ftkalcevic/DABClockRadio/DABClockRadio/main.cpp

/*
 * DABClockRadio.cpp
 *
 * Created: 24/09/2016 10:32:10 AM
 * Author : Frank Tkalcevic
 */ 

#include <avr/io.h>
#include <avr/interrupt.h>
#include <avr/pgmspace.h>
#include <avr/eeprom.h>
#include <util/delay.h>
#include <string.h>
#include <stdlib.h>
#include <time.h>

#include "..\images\font.h"

#include "ic2_7seg.h"
#include "serial.h"
#include "pictiva.h"
#include "monkeyboarddab.h"

//#include "..\..\images\consolas.h"


#define BTN_SNOOZE		0x0001
#define BTN_SLEEP		0x0002
#define BTN_RADIO_OFF	0x0004
#define BTN_RADIO_ON	0x0008
#define BTN_TIME_SET	0x0010
#define BTN_FWD_FAST	0x0020
#define BTN_FWD_SLOW	0x0040
#define BTN_ALARM1		0x0080
#define BTN_REV_FAST	0x0100
#define BTN_REV_SLOW	0x0200
#define BTN_ALARM2		0x0400
#define MAX_BUTTONS		11

#define SLAVE_ADDR (0x70<<1)

static CSerial< CSerialImpl<CMegaSerialC0,64,64>
#ifndef DEBUG
, false
#endif
> terminal;
IMPLEMENT_SERIAL_INTERRUPTS( C0, terminal )

static SevenSeg< CSerialTxn< CSerialTxnImpl< CMegaI2CE, 64, 8> >, SLAVE_ADDR> sevenSeg_I2C;
IMPLEMENT_SERIAL_TXN_INTERRUPTS(E,sevenSeg_I2C)
static CMonkeyBoardDAB<CSerial< CSerialImpl<CMegaSerialE0,64,64> >,
CSerial< CSerialImpl<CMegaSerialC0,64,64>
#ifndef DEBUG
, false
#endif
>
 > dab(&terminal);
IMPLEMENT_SERIAL_INTERRUPTS( E0, dab )
static Pictiva display;

//SevenSeg< CSerialTxn< CSerialTxnPolledImpl< CMegaI2CE > >, SLAVE_ADDR> sevenSeg_I2C;

//#define SET_CLOCK_AT_POWERUP
#define SET_CLOCK_TIMEOUT	300	// Try to set the clock for 5 minutes
static time_t clock_secs = 0;
static bool bClockInitialised=false;
static bool bDABClockEnabled = false;
static uint32_t radioTimer;

static void ScrollText(bool bRedraw=false);
static void PrimeAlarms();
static void AlarmOff();
static void RadioOff(bool bForce = false);
static void DrawMenu();
static void WriteEEPROM();
static bool DrawProgramText(bool bNewText);
static void SetPixel( uint16_t *pixel, uint8_t c, uint8_t nPos );
static void DrawSignalStength( uint8_t strength );

enum class AlarmType: uint8_t
{	
	Off=0,
	OneOff,
	Scheduled,
	Max
};

struct Alarm
{
	AlarmType type;
	// program ? -1: beeper
	uint8_t nHour;	/**< 1-12 */
	uint8_t nMin;	/**< 0-59 */
	uint8_t nAmPm;	/**< 0-1 */
	uint8_t nDay;	/**< 1-31 */
	uint8_t nMonth;	/**< 0-11 */
	uint16_t nYear;	/**< YYYY */
	uint8_t dow;			// Days of week bitmask: bit 0 is sunday.
};

#define MAX_ALARMS	4
//static Alarm alarms[MAX_ALARMS];
static time_t nNextAlarmDue;
static time_t nAlarmOffTime = 0;
static bool bAlarmOn = false;
//static uint8_t nAlarmRunTime;	// in minutes
//static uint8_t nSleepTime;		// in minutes
//static uint8_t nSnoozeTime;		// in minutes
//static uint8_t nTimeIntensity;
//static uint8_t nDABIntensity;


static struct  SEEPROMBlock
{
	uint16_t nLastPlayedProgramIndex;
	Alarm Alarms[MAX_ALARMS];
	uint8_t nAlarmRunTime;	// in minutes
	uint8_t nSleepTime;		// in minutes
	uint8_t nSnoozeTime;	// in minutes
	uint8_t nTimeIntensity;
	uint8_t nDABIntensity;
	uint16_t crc16;			// CRC of eeProgram[20] to verify if EEPROM has been set.
} settings;

SEEPROMBlock eeprom_data EEMEM;

// Display mode - what is the display showing.
enum class DisplayMode: uint8_t
{
	Off,
	Playing,
	Tuner,
	Menu,
	Scanning
} displayMode = DisplayMode::Off;


// Program Info
struct Programs
{
	const char *sShortName;
	const char *sLongName;
};
static Programs *programs;
static uint16_t nPrograms;
static uint16_t nProgramIdx;
static char *sProgramNames;
//static uint16_t nLastPlayedProgramIndex;
//static char sLastPlayedProgram[sizeof(eeProgram)];
static uint8_t lastSignalStrength =0;

static uint16_t nNextProgram;
static uint8_t nLastVolume = 0;	// What the volume is.
static uint8_t volumeSetting = 0;	// What to set it to.


// Programme text and scrolling.
#define PROGRAM_TEXT_POS	36
static char sCurrentProgramText[256];
static uint16_t textXShift = 0, textXShiftMax;
static int16_t xoffs;




static enum class ClockRadioState: uint8_t
{
	Off,
	Idle,
	Menu
} clockRadioState = ClockRadioState::Off;


static uint16_t nTunerPosition, nTunerTarget;
const int16_t TUNER_WIDTH = 120;	// Multiple of 3
const int16_t TUNER_WIDTH_WORDS = TUNER_WIDTH/3;	// Multiple of 3
const int16_t SELECTOR_WIDTH = TUNER_WIDTH/2;
const int16_t ROW_HEIGHT = 12;
static uint16_t *paintBuffer;

static void InitI2C()
{
	PR.PRPE &= ~PR_TWI_bm;
	sevenSeg_I2C.Init();
}

static void ClearDisplay()
{
	sevenSeg_I2C.ClearDisplay();
}

static void FlashColon(bool bOn)
{
	// at the 1/2 second mark, turn off the colon (row 4)
	uint8_t data[] = {SLAVE_ADDR, 4, (uint8_t)(bOn?0xFF:0), 0 };
	sevenSeg_I2C.SendTxn(data, countof(data));
}


static void ShowTime( long nSeconds )
{
	struct tm t;

	gmtime_r((time_t*)&nSeconds, &t);

	//terminal.Send( "Tick ");
	//terminal.Send(t.tm_mday);
	//terminal.Send('/');
	//terminal.Send(t.tm_mon);
	//terminal.Send('/');
	//terminal.Send(t.tm_year+1900);
	//terminal.Send(' ');
	//
	//if (t.tm_hour < 10 )
	//terminal.Send(' ');
	//terminal.Send(t.tm_hour);
	//terminal.Send( ":");
	//if ( t.tm_min < 10 )
	//terminal.Send('0');
	//terminal.Send(t.tm_min);
	//terminal.Send( ":");
	//if ( t.tm_sec < 10 )
	//terminal.Send('0');
	//terminal.Send(t.tm_sec);
	//terminal.SendCRLF();

	static const uint8_t numbertable[] = {
		0x3F, /* 0 */
		0x06, /* 1 */
		0x5B, /* 2 */
		0x4F, /* 3 */
		0x66, /* 4 */
		0x6D, /* 5 */
		0x7D, /* 6 */
		0x07, /* 7 */
		0x7F, /* 8 */
		0x6F /* 9 */
	};

	bool pm = false;
	struct 
	{
		uint8_t addr;
		uint8_t row;
		uint16_t data[5];
	} data;
	data.addr = SLAVE_ADDR;
	data.row = 0;
	if ( t.tm_hour > 12 )
	{
		t.tm_hour -= 12;
		pm = true;
	}
	if ( t.tm_hour == 0 )
		t.tm_hour = 12;
	if ( t.tm_hour < 10 )
		data.data[0] = 0;
	else
	{
		data.data[0] = numbertable[1];
		t.tm_hour -= 10;
	}
	data.data[1] = numbertable[t.tm_hour];
	//data[2] = (nSeconds & 1) ? 0xFF : 0;
	data.data[2] = 0xFF;

	data.data[3] = numbertable[t.tm_min/10];
	data.data[4] = numbertable[t.tm_min%10];

	if ( pm )
		data.data[4] |= 0x80;
	
	sevenSeg_I2C.SendTxn( (uint8_t *)&data, sizeof(data) );
}

static void ShowProgram()
{
	const char *sProgram = programs[settings.nLastPlayedProgramIndex].sLongName;

	terminal.Send("ProgramName: ");
	terminal.Send(sProgram);
	terminal.SendCRLF();

	if (  displayMode == DisplayMode::Playing )
	{
		display.ClearWindow( 0, 0, OP_SCREENW - 16*(font_6x13.cols+1), 2*ROW_HEIGHT, true ); 
		display.WriteText( &font_MSShell, 0, 0, sProgram );
	}
}

const char *WeekDay[] = {"Sun","Mon","Tue","Wed","Thu","Fri","Sat"};
const char *Month[] = {"Jan","Feb","Mar","Apr","May","Jun","Jul","Aug","Sep","Oct","Nov","Dec"};

static void ShowDate()
{
	if ( displayMode == DisplayMode::Playing )
	{
		struct tm t;

		gmtime_r((time_t*)&clock_secs, &t);

	
		char s[16];	//Thu 20 Dec 2016
		memset( s, ' ', sizeof(s) );
		uint8_t n = 0;

		if ( t.tm_mday < 10 )
			n++;

		s[n++] = WeekDay[t.tm_wday][0];
		s[n++] = WeekDay[t.tm_wday][1];
		s[n++] = WeekDay[t.tm_wday][2];
		n++;

		if ( t.tm_mday >= 10 )
			s[n++] = '0' + (t.tm_mday / 10 );
		s[n++] =  '0' + (t.tm_mday % 10 );
		n++;

		s[n++] = Month[t.tm_mon][0];
		s[n++] = Month[t.tm_mon][1];
		s[n++] = Month[t.tm_mon][2];
		n++;

		uint16_t y = t.tm_year + 1900;
		s[n++] = '0' + y/1000;
		s[n++] = '0' + (y%1000)/100;
		s[n++] = '0' + (y%100)/10;
		s[n++] = '0' + (y%10);
		s[n] = '\0';

		display.WriteText( &font_6x13, OP_SCREENW - 1 - (font_6x13.cols + 1)*n, 0, s );
	}
}

static void UpdateTime( struct tm &t )
{
	uint32_t seconds = mktime(&t);

	if ( abs((int32_t)seconds -  (int32_t)clock_secs) > 5 )
	{
		bClockInitialised = true;
		terminal.Send( "Setting time: " );
		terminal.Send( (long)seconds );
		terminal.SendCRLF();
		clock_secs = seconds;
		PrimeAlarms();
		ShowTime(clock_secs);
	}
}


static volatile uint32_t ms;

ISR(TCC0_OVF_vect)
{
	ms++;
}

static void ioinit()
{
	// Turn of all peripherals
	PR.PRGEN = 0xFF;
	PR.PRPA = 0xFF;
	//PR.PRPB = 0xFF;
	PR.PRPC = 0xFF;
	PR.PRPD = 0xFF;
	PR.PRPE = 0xFF;
	PR.PRPF = 0xFF;

	// main clock to 32MHz

	// Enable 16MHz Ext Crystal
	OSC.XOSCCTRL = OSC_XOSCSEL_XTAL_256CLK_gc | OSC_FRQRANGE_12TO16_gc;
	OSC.CTRL |= OSC_XOSCEN_bm;
	// Wait till stable.
	while ( (OSC.STATUS & OSC_XOSCRDY_bm) == 0 )
		continue;

	// PLL x2
	OSC.PLLCTRL = OSC_PLLSRC_XOSC_gc | 2;
	OSC.CTRL |= OSC_PLLEN_bm;
	while ( (OSC.STATUS & OSC_PLLRDY_bm) == 0 )
		continue;

	// Select it as the new clock
	_PROTECTED_WRITE(CLK_PSCTRL, 0);
	_PROTECTED_WRITE(CLK_CTRL, CLK_SCLKSEL_PLL_gc);


	// RTC 
	PR.PRGEN &= ~PR_RTC_bm;
	CLK.RTCCTRL =  CLK_RTCSRC_TOSC_gc | CLK_RTCEN_bm;
	RTC.CTRL = RTC_PRESCALER_DIV256_gc;						// 1024Hz / 256 -> 4Hz (so we can flash the : each 1/2 second)

	//// Enable dfll32m
	//OSC.XOSCCTRL = OSC_XOSCSEL_32KHz_gc;
	//OSC.CTRL |= OSC_XOSCEN_bm;
	////while ( (OSC.STATUS & OSC_XOSCRDY_bm) == 0 )
		////continue;
	//OSC.DFLLCTRL = OSC_RC32MCREF_XOSC32K_gc;
	//DFLLRC32M.CTRL = DFLL_ENABLE_bm;

	InitI2C();

	// TCC0 ms counter.
	PR.PRPC &= ~PR_TC0_bm;
	TCC0.CTRLA = TC_CLKSEL_DIV64_gc;
	TCC0.CTRLB = TC_WGMODE_NORMAL_gc;
	TCC0.CTRLC = 0;
	TCC0.CTRLD = 0;
	TCC0.CTRLE = 0;
	TCC0.INTCTRLA = TC_OVFINTLVL_LO_gc;
	TCC0.INTCTRLB = 0;
	TCC0.PER = 500;

	// USART C0 - debug terminal
	PR.PRPC &= ~PR_USART0_bm;
	PORTC.DIRSET = PIN3_bm;	// TX is output, RX is input
	PORTC.OUTSET = PIN3_bm;	// set high

    // Encoder  - Using pins C0,C1 timer C1 and event channel 0
	PR.PRGEN  &= ~PR_EVSYS_bm;
	PR.PRPC &= ~PR_TC1_bm;

    PORTC.DIRCLR = PIN0_bm | PIN1_bm;
    PORTC.PIN0CTRL = PORT_OPC_PULLUP_gc | PORT_ISC_LEVEL_gc;
    PORTC.PIN1CTRL = PORT_OPC_PULLUP_gc | PORT_ISC_LEVEL_gc;
    
    EVSYS.CH0MUX = EVSYS_CHMUX_PORTC_PIN0_gc;
    EVSYS.CH0CTRL = EVSYS_QDEN_bm | EVSYS_DIGFILT_2SAMPLES_gc;
    
    TCC1.CTRLD = TC_EVACT_QDEC_gc | TC_EVSEL_CH0_gc;
    TCC1.PER = 0xFFFF;
    TCC1.CTRLA = TC_CLKSEL_DIV1_gc;

	// Key pins - b is always pull down input
	PORTCFG.MPCMASK = 0x3;
	PORTB.PIN0CTRL = PORT_OPC_PULLDOWN_gc;
	PORTB.DIRCLR = 3;

	// USART E0 - DAB
	PR.PRPE &= ~PR_USART0_bm;
	PORTE.DIRSET = PIN3_bm;	// TX is output, RX is input
	PORTE.PIN2CTRL = PORT_OPC_PULLUP_gc;
	PORTE.OUTSET = PIN3_bm;	// set high

	display.Init();
	display.InitDisplay();

	// ADC (volume)
	PR.PRPA &= ~PR_ADC_bm;
	ADCA.CTRLA =  ADC_ENABLE_bm;
	ADCA.CTRLB = ADC_FREERUN_bm;
	ADCA.REFCTRL = ADC_REFSEL_INTVCC_gc;
	ADCA.PRESCALER = ADC_PRESCALER_DIV512_gc;

	ADCA.CH0.CTRL = ADC_CH_INPUTMODE_SINGLEENDED_gc;
	ADCA.CH0.MUXCTRL = ADC_CH_MUXPOS_PIN10_gc;
	ADCA.CH0.CTRL |= ADC_CH_START_bm;

	// Enable interrupt controller
	PMIC.CTRL = PMIC_LOLVLEN_bm | PMIC_MEDLVLEN_bm | PMIC_HILVLEN_bm;
}

static uint16_t PollPins( uint8_t pin, uint8_t next_pin )
{
	uint16_t n = (PORTA.IN & ~_BV(pin)) | ((PORTB.IN & 3) << 8);

	uint8_t nMask = 1 << next_pin;

	// Keypad keys A0-8 B0-1
	PORTCFG.MPCMASK = 0xFF;
	PORTA.PIN0CTRL = PORT_OPC_PULLDOWN_gc;

	PORTA.DIR = nMask;
	PORTA.OUTSET = nMask;

	return n;
}

#define DEBOUNCE_TIME	50	// ms
static uint16_t keydown = 0;

static uint16_t DebounceKeys(uint16_t keystate)
{
	static uint8_t button_timer[MAX_BUTTONS];
	static uint16_t pressing=0;
	static uint16_t pressed=0;
	uint16_t keychange = 0;

	uint16_t mask = 1;
	for ( int i = 0; i< MAX_BUTTONS; i++, mask <<= 1)
	{
		if ( pressing & mask )	
		{
			if ( keystate & mask )	// still pressing
			{
				button_timer[i]--;
				if ( button_timer[i] == 0 )
				{
					pressing &= ~mask;
					pressed |= mask;
					keychange |= mask;
					keydown |= mask;
				}
			}
			else
			{
				// Not pressing
				pressing &= ~mask;
			}
		}
		else if ( pressed & mask )
		{
			if ( ( keystate & mask ) == 0 )
			{
				pressed &= ~mask;
				keychange |= mask;
				keydown &= ~mask;
			}
		}
		else
		{
			if ( keystate & mask )
			{
				pressing |= mask;
				button_timer[i] = DEBOUNCE_TIME;
			}
		}
	}

	return keychange;
}

static uint16_t PollKeyboard()
{
	// A1 - S1-A2 S3-A4 S9-A5 S10-A6
	// A3 - S0-A2 S2-A4 S4-A0 S6-A5 S7-A7
	// A5 - S5-B0 S6-A3 S8-B1 S9-A1
	uint16_t keys = 0;
	uint8_t n1 = PollPins(1,3);
	uint8_t n2 = PollPins(3,5);
	uint16_t n3 = PollPins(5,1);
	if ( n1 & _BV(2) ) keys |= _BV(1);
	if ( n1 & _BV(4) ) keys |= _BV(3);
	if ( n1 & _BV(5) ) keys |= _BV(9);
	if ( n1 & _BV(6) ) keys |= _BV(10);

	if ( n2 & _BV(2) ) keys |= _BV(0);
	if ( n2 & _BV(4) ) keys |= _BV(2);
	if ( n2 & _BV(0) ) keys |= _BV(4);
	if ( n2 & _BV(5) ) keys |= _BV(6);
	if ( n2 & _BV(7) ) keys |= _BV(7);

	if ( n3 & _BV(8) ) keys |= _BV(5);
	if ( n3 & _BV(3) ) keys |= _BV(6);
	if ( n3 & _BV(9) ) keys |= _BV(8);
	if ( n3 & _BV(1) ) keys |= _BV(9);

	return DebounceKeys(keys);
}


//static void PrintDABDetails()
//{
	//bool bClockSet = false;
	//{
		//if ( dab.RTC_GetClockStatus(bClockSet))
		//{
			//terminal.Send("Clock Status: ");
			//terminal.Send(bClockSet?"Set\r\n":"Unset\r\n");
		//}
		//else
		//{
			//terminal.Send("Failed to get clock status\r\n");
		//}
	//}
//
	//if ( bClockSet )
	//{
		//uint8_t day, month, hour, minute, second;
		//uint16_t year;
		//if ( dab.RTC_GetClock(day,month,year,hour,minute,second))
		//{
			//terminal.Send("Clock: ");
			//terminal.Send( day );
			//terminal.Send( '/' );
			//terminal.Send( month );
			//terminal.Send( '/' );
			//terminal.Send( (int)year );
			//terminal.Send( ' ' );
			//terminal.Send( hour );
			//terminal.Send( ':' );
			//terminal.Send( minute );
			//terminal.Send( ':' );
			//terminal.Send( second );
			//terminal.SendCRLF();
//
			//struct tm t;
			//t.tm_year = year-1900;
			//t.tm_mon = month;
			//t.tm_mday = day;
			//t.tm_hour = hour;
			//t.tm_min = minute;
			//t.tm_sec = second;
//
			//UpdateTime( t );
		//}
		//else
		//{
			//terminal.Send("Failed to read clock\r\n");
		//}
	//}
//
	//{
		//uint16_t nPrograms;
		//if ( dab.STREAM_GetTotalProgram(nPrograms) )
		//{
			//terminal.Send( "Found ");
			//terminal.Send( (int)nPrograms );
			//terminal.Send( " DAB programs\r\n" );
		//}
		//else
		//{
			//terminal.Send( "Error reading DAB programs\r\n" );
		//}
	//}
//
	//DABPlayStatus nPlayStatus = DABPlayStatus::Stop;
	//{
		//if ( dab.STREAM_GetPlayStatus(nPlayStatus) )
		//{
			//terminal.Send( "DAB Play Status = ");
			//switch (nPlayStatus)
			//{
				//case DABPlayStatus::Playing: terminal.Send("Playing\r\n"); break;
				//case DABPlayStatus::Searching: terminal.Send("Searching\r\n"); break;
				//case DABPlayStatus::Tuning: terminal.Send("Tuning\r\n"); break;
				//case DABPlayStatus::Stop: terminal.Send("Stop\r\n"); break;
				//case DABPlayStatus::SortingChange: terminal.Send("Sorting Change\r\n"); break;
				//case DABPlayStatus::Reconfiguration: terminal.Send("Reconfiguration\r\n"); break;
				//default: terminal.Send((int)nPlayStatus); terminal.SendCRLF(); break;
			//}
		//}
		//else
		//{
			//terminal.Send( "Error reading DAB play status\r\n" );
		//}
	//}
//
	//{
		//DABPlayMode nPlayMode;
		//if ( dab.STREAM_GetPlayMode(nPlayMode) )
		//{
			//terminal.Send( "DAB Play Mode = ");
			//switch (nPlayMode)
			//{
				//case DABPlayMode::AM: terminal.Send("AM\r\n"); break;
				//case DABPlayMode::BEEPER: terminal.Send("BEEPER\r\n"); break;
				//case DABPlayMode::DAB: terminal.Send("DAB\r\n"); break;
				//case DABPlayMode::FM: terminal.Send("FM\r\n"); break;
				//case DABPlayMode::StreamStop: terminal.Send("Stream Stop\r\n"); break;
				//default: terminal.Send((int)nPlayMode); terminal.SendCRLF(); break;
			//}
		//}
		//else
		//{
			//terminal.Send( "Error reading DAB play status\r\n" );
		//}
	//}
//
	//{
		//uint32_t nIndex;
		//if ( dab.STREAM_GetPlayIndex(nIndex ) )
		//{
			//terminal.Send( "Play Index=" );
			//terminal.Send( (long)nIndex );
			//terminal.Send( "\r\n" );
		//}
		//else
		//{
			//terminal.Send( "Failed to read play index\r\n" );
		//}
	//}
//
	//if ( nPlayStatus != DABPlayStatus::Stop )
	//{
		//uint8_t nStrength; uint16_t nBitErrorRate;
		//if ( dab.STREAM_GetSignalStrength( nStrength, nBitErrorRate) )
		//{
			//terminal.Send( "Strength=" );
			//terminal.Send( (int)nStrength );
			//terminal.Send( ", Bit Error Rate=" );
			//terminal.Send( (int)nBitErrorRate );
			//terminal.Send( "\r\n" );
		//}
		//else
		//{
			//terminal.Send( "Failed to read signal strength\r\n" );
		//}
	//}
	//if ( nPlayStatus == DABPlayStatus::Playing )
	//{
		//char text[200];
		//if ( dab.STREAM_GetProgrammeText(text,sizeof(text)) )
		//{
			//terminal.Send("Program Text: ");
			//terminal.Send(text);
			//terminal.SendCRLF();
		//}
		//else
		//{
			//terminal.Send("Failed to read Program Text\r\n");
		//}
	//}
//
	//{
		//bool bEnabled;
		//if ( dab.RTC_GetSyncClockStatus(bEnabled))
		//{
			//terminal.Send("Clock Sync Status: ");
			//terminal.Send(bEnabled?"Enabled\r\n":"Disabled\r\n");
		//}
		//else
		//{
			//terminal.Send("Failed to get clock sync status\r\n");
		//}
	//}
//}

//static void PrintDABStations()
//{
	//uint16_t nPrograms;
	//if ( dab.STREAM_GetTotalProgram(nPrograms) )
	//{
		//terminal.Send( "Found ");
		//terminal.Send( (int)nPrograms );
		//terminal.Send( " DAB programs\r\n" );
	//}
	//else
	//{
		//terminal.Send( "Error reading DAB programs\r\n" );
	//}
//
	//for ( uint16_t i = 0; i < nPrograms; i++ )
	//{
		//char buf[120];
		//if ( dab.STREAM_GetProgrammeName( i, false, buf, sizeof(buf) ) )
		//{
			//terminal.Send( (int)i );
			//if ( i < 10 )
			//terminal.Send(' ');
			//terminal.Send(' ');
			//terminal.Send( buf );
			//for ( unsigned int j = 0; j < 9 - strlen(buf); j++)
			//terminal.Send(' ');
//
			//if ( dab.STREAM_GetProgrammeName( i, true, buf, sizeof(buf) ) )
			//{
				//terminal.Send( buf );
				//terminal.SendCRLF();
			//}
		//}
	//}
//}


static enum class RadioState: uint8_t
{
	Init,
	WaitForReply,
	Off,
	InitStartUpTasks,
	StartUpTasks,
	StartUpTasksPause,
	WaitForTaskReply,

	StartPlaying,
	InitStartTasks,
	Playing,
	PlayingNext,
	StartScanning,
	InitScanTasks,
	ScanDone
} radioState = RadioState::Init, successState, failState, taskDoneState;
static int8_t task;

void SetWaitForReply( RadioState success, RadioState failure)
{
	radioState = RadioState::WaitForReply;
	successState = success;
	failState = failure;
}


enum class TaskReturn: uint8_t
{
	Done,
	Fail,
	Continue
};

enum class TaskInit: uint8_t
{
	OK,
	Fail,
	Skip
};

#define MAX_TASKS	15
static struct StartupTaskFuncs
{
	TaskInit (*init)();
	TaskReturn (*check)(AsyncReturnCode ret);

} TaskList[MAX_TASKS];
uint8_t nTaskCount;


static TaskInit funcSetVolume0_init() 
{
	dab.STREAM_SetVolume_Async(0, ms );
	return TaskInit::OK;
} 

static TaskInit funcSetVolume_init()
{
	dab.STREAM_SetVolume_Async(nLastVolume, ms );
	return TaskInit::OK;
}


static TaskInit funcSetNotifications_init()
{
	dab.NOTIFY_SetNotification_Async(   (DABNotification)((uint16_t)DABNotification::ScanFinished |
										(uint16_t)DABNotification::NewFMText |
										(uint16_t)DABNotification::DABReconfig |
										(uint16_t)DABNotification::DABChanChange |
										(uint16_t)DABNotification::FMRDSGrpNotify |
										(uint16_t)DABNotification::NewDABText |
										(uint16_t)DABNotification::ScanFrequency), ms );
	return TaskInit::OK;
}

static TaskReturn ack_check(AsyncReturnCode ret) 
{
	if ( ret == AsyncReturnCode::ReplAck )
		return TaskReturn::Done;
	else
		return TaskReturn::Fail;
} 

static TaskInit funcEnableSyncClock_init() 
{
	dab.RTC_EnableSyncClock_Async(1, ms );
	return TaskInit::OK;
}

static TaskReturn funcGetSyncClockStatus_check(AsyncReturnCode ret)
{
	bool bSet = false;
	if ( ret == AsyncReturnCode::ReplAck )
	{
		bSet = dab.MsgBuffer()[0] != 0;
	}
	return bSet ? TaskReturn::Done : TaskReturn::Fail;
}

static TaskInit funcGetSyncClockStatus_init()
{
	dab.RTC_GetSyncClockStatus_Async( ms );
	return TaskInit::OK;
}

static TaskReturn funcGetClockStatus_check(AsyncReturnCode ret)
{
#ifdef SET_CLOCK_AT_POWERUP
	bool bEnabled = false;
	if ( ret == AsyncReturnCode::ReplAck )
	{
		bEnabled = dab.MsgBuffer()[0] != 0;
	}

	if ( bEnabled )
	{
		bDABClockEnabled = bEnabled;
	}
	else
	{
		if ( clock_secs > SET_CLOCK_TIMEOUT )
		{
			terminal.Send("set clock timeout\r\n");
			return TaskReturn::Done;	// give up
		}
		else
			return TaskReturn::Fail;	
	}

	return bEnabled ? TaskReturn::Done : TaskReturn::Fail;
#else
	PrimeAlarms();
	return TaskReturn::Done;
#endif
}

static TaskReturn funcGetClockStatusOptional_check(AsyncReturnCode ret)
{
	if ( ret == AsyncReturnCode::ReplAck )
	{
		bDABClockEnabled = dab.MsgBuffer()[0] != 0;
	}
	return TaskReturn::Done;
}

static TaskInit funcGetClockStatus_init()
{
	dab.RTC_GetClockStatus_Async( ms );
	return TaskInit::OK;
}

static TaskInit funcGetClock_init()
{
	if ( bDABClockEnabled )
	{
		dab.RTC_GetClock_Async(ms);
		return TaskInit::OK;
	}
	else
		return TaskInit::Skip;
}

static TaskReturn funcGetClock_check(AsyncReturnCode ret)
{
	if ( ret == AsyncReturnCode::ReplAck )
	{
		uint8_t *input = dab.MsgBuffer();

		struct tm t;
		t.tm_year = input[6] + 2000 - 1900;
		t.tm_mon = input[5]-1;
		t.tm_mday = input[3];
		t.tm_hour = input[2];
		t.tm_min = input[1];
		t.tm_sec = input[0];
		t.tm_isdst = 0;

		// Quick sanity check
		if ( t.tm_year > 115 && t.tm_year < 200 &&
			 t.tm_mon < 12 &&
			 t.tm_mday > 0 && t.tm_mday <= 31 &&
			 t.tm_hour < 24 &&
			 t.tm_min < 60 &&
			 t.tm_sec < 60 )
		{
			UpdateTime( t );
		}
		else
		{
			terminal.Send("Dud time");
			return TaskReturn::Fail;
		}

		if ( radioState != RadioState::Off )
			ShowDate();

		return TaskReturn::Done;
	}
	else
	{
		if ( clock_secs > SET_CLOCK_TIMEOUT )
		{
			terminal.Send("get clock timeout\r\n");
			return TaskReturn::Done;	// give up
		}
		else
			return TaskReturn::Fail;	
	}
}

static TaskReturn funcGetClock_Optional_check(AsyncReturnCode ret)
{
	funcGetClock_check(ret);
	return TaskReturn::Done;
}

static TaskInit funcGetProgramCount_init()
{
	dab.STREAM_GetTotalProgram_Async(ms);
	return TaskInit::OK;
}

static TaskReturn funcGetProgramCount_check(AsyncReturnCode ret)
{
	if ( ret == AsyncReturnCode::ReplAck )
	{
		nPrograms =  dab.MsgBuffer()[3] | ( dab.MsgBuffer()[2]<<8);	// use only the 2 low bytes.
		uint16_t program_space = sizeof(Programs)*nPrograms;
		memset( programs, 0, program_space );
		sProgramNames = (char *)programs + program_space;
		nProgramIdx = 0;
		if ( settings.nLastPlayedProgramIndex >= nPrograms )
			settings.nLastPlayedProgramIndex = 0;
		return TaskReturn::Done;
	}
	else
		return TaskReturn::Fail;
}

static TaskInit funcGetPrograms_init()
{
	bool bFullName = programs[nProgramIdx].sLongName == NULL ? true: false;
	dab.STREAM_GetProgrammeName_Async(nProgramIdx, bFullName, sProgramNames, 256, ms);
	return TaskInit::OK;
}

static TaskReturn funcGetPrograms_check(AsyncReturnCode ret)
{
	if ( ret == AsyncReturnCode::ReplAck )
	{
		bool bFullName = programs[nProgramIdx].sLongName == NULL ? true: false;
		const char *sText = sProgramNames;
		if ( bFullName )
			programs[nProgramIdx].sLongName = sProgramNames;
		else
			programs[nProgramIdx].sShortName = sProgramNames;

		// Remove trailing white space
		uint8_t i = dab.MsgLen();
		while ( i > 0 &&  (sProgramNames[i-1] == ' ' || sProgramNames[i-1] == 0 ) )
			i--;
		sProgramNames += i;
		*(sProgramNames++) = '\0';
		terminal.Send(nProgramIdx);
		terminal.Send(" ");
		terminal.Send(sText);
		terminal.SendCRLF();

		if ( bFullName ) // still need to do the short name
			return TaskReturn::Continue;

		nProgramIdx++;
		if ( nProgramIdx < nPrograms )
			return TaskReturn::Continue;
		else
		{
			nNextProgram = settings.nLastPlayedProgramIndex;
			return TaskReturn::Done;
		}
	}
	else if ( ret == AsyncReturnCode::ReplyNack )
	{
		// Nack probably means there are no programs.
		return TaskReturn::Done;
	}
	else
		return TaskReturn::Fail;
}

static TaskInit funcPlayProgramForTime_init()
{
	dab.STREAM_Play_Async(DABPlayMode::DAB,settings.nLastPlayedProgramIndex,ms);
	return TaskInit::OK;
}

static TaskInit funcPlayProgram_init()
{
	ShowProgram();
	*sCurrentProgramText = 0;
	DrawProgramText(true);
	dab.STREAM_Play_Async(DABPlayMode::DAB,settings.nLastPlayedProgramIndex,ms);
	return TaskInit::OK;
}

static TaskInit funcStopPlaying_init()
{
	dab.STREAM_Stop_Async(ms);
	return TaskInit::OK;
}

static TaskInit funcPowerOff_init()
{
	dab.PowerOff();
	display.displayPowerOff();
	bDABClockEnabled = false;
	return TaskInit::OK;
}

void InitStartUpTasks()
{
	task = 0;
	nTaskCount = 0;

	TaskList[nTaskCount++] = { funcSetVolume0_init, ack_check };
	TaskList[nTaskCount++] = { funcEnableSyncClock_init, ack_check };
	TaskList[nTaskCount++] = { funcGetProgramCount_init, funcGetProgramCount_check };
	TaskList[nTaskCount++] = { funcGetPrograms_init, funcGetPrograms_check };
	TaskList[nTaskCount++] = { funcGetSyncClockStatus_init, funcGetSyncClockStatus_check };
#ifdef SET_CLOCK_AT_POWERUP
	TaskList[nTaskCount++] = { funcPlayProgramForTime_init, ack_check };
	TaskList[nTaskCount++] = { funcGetClockStatus_init, funcGetClockStatus_check };
	TaskList[nTaskCount++] = { funcGetClock_init, funcGetClock_check };
	TaskList[nTaskCount++] = { funcStopPlaying_init, ack_check };
#else
	bClockInitialised = true;
#endif
	TaskList[nTaskCount++] = { funcPowerOff_init, NULL };
}

static TaskInit funcGetProgramText_init()
{
	dab.STREAM_GetProgrammeText_Async( sProgramNames, 256, ms);
	return TaskInit::OK;
}


static TaskReturn funcGetProgramText_check(AsyncReturnCode ret)
{
	if ( ret == AsyncReturnCode::ReplAck )
	{
		// TODO : move unicode conversion into receiver.
		char *text = sProgramNames;
		*(text+dab.MsgLen()) = '\0';
		terminal.Send("ProgramText: ");
		terminal.Send(text);
		terminal.SendCRLF();
		//display.WriteText( &font_6x13, 0, 11, text );
		ScrollText(true);
		return TaskReturn::Done;
	}
	else if ( ret == AsyncReturnCode::ReplyNack )
	{
		// nothing there.
		terminal.Send("ProgramText: ");
		if ( dab.MsgBuffer()[0] == 0 )
			terminal.Send("No Text\r\n");
		else
			terminal.Send("No New Text\r\n");
		return TaskReturn::Done;
	}
	return TaskReturn::Fail;
}

static void InitStartTasks()
{
	task = 0;
	nTaskCount = 0;

	TaskList[nTaskCount++] = { funcPlayProgram_init, ack_check };
	TaskList[nTaskCount++] = { funcEnableSyncClock_init, ack_check };
	TaskList[nTaskCount++] = { funcSetVolume_init, ack_check };
	TaskList[nTaskCount++] = { funcSetNotifications_init, ack_check };
	TaskList[nTaskCount++] = { funcGetProgramText_init, funcGetProgramText_check };
}



static TaskInit funcClearDatabase_init() 
{
	dab.STREAM_ClearDatabase_Async(ms);
	display.WriteText(&font_6x13,0,ROW_HEIGHT*0,"Scanning");
	return TaskInit::OK;
}

static uint8_t nScanCount;
static TaskInit funcDABAutoScan_init() 
{
	nScanCount = 0;
	dab.STREAM_AutoSearch_Async(0,40,ms);
	return TaskInit::OK;
}

static TaskInit funcWaitForAutoScan_init() 
{
	if ( (nScanCount & 1) == 0 )
	{
		dab.STREAM_GetPlayStatus_Async(ms);
	}
	else if ( (nScanCount & 2) == 0 )
	{
		dab.STREAM_GetFrequency_Async(0,ms);
	}
	else
	{
		dab.STREAM_GetTotalProgram_Async(ms);
	}
	return TaskInit::OK;
}

static TaskReturn funcWaitForAutoScan_check(AsyncReturnCode ret)
{
	if ( ret == AsyncReturnCode::ReplAck )
	{
		if ( (nScanCount & 1) == 0 )
		{
			if ( dab.MsgBuffer()[0] != (int8_t)DABPlayStatus::Searching )
				return TaskReturn::Done;
		}
		else if ( (nScanCount & 2) == 0 )
		{
			uint8_t nFreqIndex = dab.MsgBuffer()[0];
			char s[20];
			strcpy( s, "Freq: " );
			itoa( nFreqIndex, s+strlen(s), 10 );
			display.WriteText(&font_6x13,0,ROW_HEIGHT*1,s);
		}
		else
		{
			uint16_t nPrograms =  dab.MsgBuffer()[3] | ( dab.MsgBuffer()[2]<<8);	// use only the 2 low bytes.
			char s[20];
			strcpy( s, "Programs: " );
			itoa( nPrograms, s+strlen(s), 10 );
			display.WriteText(&font_6x13,0,ROW_HEIGHT*2,s);
		}
		nScanCount++;
	}
	return TaskReturn::Fail;
}

static void InitScanTasks()
{
	task = 0;
	nTaskCount = 0;

	TaskList[nTaskCount++] = { funcClearDatabase_init, ack_check };
	TaskList[nTaskCount++] = { funcDABAutoScan_init, ack_check };
	TaskList[nTaskCount++] = { funcWaitForAutoScan_init, funcWaitForAutoScan_check };
	TaskList[nTaskCount++] = { funcGetProgramCount_init, funcGetProgramCount_check };
	TaskList[nTaskCount++] = { funcGetPrograms_init, funcGetPrograms_check };
}

/*
static TaskReturn funcGetProgramTextNotify_check(AsyncReturnCode ret)
{
	if ( ret == AsyncReturnCode::ReplAck )
	{
		char *text = sProgramNames;
		*(text+dab.MsgLen()) = '\0';
		terminal.Send("ProgramText: ");
		terminal.Send(text);
		terminal.SendCRLF();
		//display.WriteText( &font_6x13, 0, 11, text );
		ScrollText(true);
		return TaskReturn::Done;
	}
	return TaskReturn::Fail;
}
*/

static void InitGetProgramTextTasks()
{
	task = 0;
	nTaskCount = 0;

	TaskList[nTaskCount++] = { funcGetProgramText_init, funcGetProgramText_check };
	//PollTaskList[nTaskCount++] = { funcGetProgramText_init, funcGetProgramTextNotify_check };
}

static TaskInit funcChangeProgram_init() 
{ 
	if ( nNextProgram != settings.nLastPlayedProgramIndex )
	{
		settings.nLastPlayedProgramIndex = nNextProgram;
		WriteEEPROM();
		return funcPlayProgram_init();
	}
	return TaskInit::Skip;
}

static TaskInit funcGetPlayStatus_init() 
{ 
	dab.STREAM_GetPlayStatus_Async(ms); 
	return TaskInit::OK; 
}
static TaskReturn funcGetPlayStatus_check(AsyncReturnCode ret) 
{ 
	if ( ret == AsyncReturnCode::ReplAck )
	{
		terminal.Send("Play Status: ");
		terminal.Send(dab.MsgBuffer()[0]);
		terminal.SendCRLF();
		return TaskReturn::Done;
	}
	return TaskReturn::Fail;
}
static TaskInit funcGetPlayMode_init() 
{	
	dab.STREAM_GetPlayMode_Async(ms); 
	return TaskInit::OK; 
}
static TaskReturn funcGetPlayMode_check(AsyncReturnCode ret) 
{ 
	if ( ret == AsyncReturnCode::ReplAck )
	{
		terminal.Send("Play Mode: ");
		terminal.Send(dab.MsgBuffer()[0]);
		terminal.SendCRLF();
		return TaskReturn::Done;
	}
	return TaskReturn::Fail;
}
static TaskInit funcGetPlayIndex_init() 
{ 
	dab.STREAM_GetPlayIndex_Async(ms); 
	return TaskInit::OK; 
}
static TaskReturn funcGetPlayIndex_check(AsyncReturnCode ret) 
{ 
	if ( ret == AsyncReturnCode::ReplAck )
	{
		terminal.Send("Play Index: ");
		terminal.Send(dab.MsgBuffer()[3]);
		terminal.SendCRLF();
		return TaskReturn::Done;
	}
	return TaskReturn::Fail;
}
static TaskInit funcGetSignalStrength_init() 
{ 
	dab.STREAM_GetSignalStrength_Async(ms); 
	return TaskInit::OK; 
}
static TaskReturn funcGetSignalStrength_check(AsyncReturnCode ret) 
{ 
	if ( ret == AsyncReturnCode::ReplAck )
	{
		uint8_t strength = dab.MsgBuffer()[0];
		uint16_t errors = (dab.MsgBuffer()[1] << 8) | dab.MsgBuffer()[2];
		if ( strength != lastSignalStrength )
			DrawSignalStength( strength );
		terminal.Send("Signal Strength: ");
		terminal.Send(strength);
		terminal.Send(" Errors: ");
		terminal.SendHex((int)errors);
		terminal.SendCRLF();
		return TaskReturn::Done;
	}
	else if ( ret == AsyncReturnCode::ReplyNack )
	{
		return TaskReturn::Done;
	}
	return TaskReturn::Fail;
}

static TaskInit funcGetStereo_init() 
{ 
	dab.STREAM_GetStereo_Async(ms); 
	return TaskInit::OK; 
}
static TaskReturn funcGetStereo_check(AsyncReturnCode ret) 
{ 
	if ( ret == AsyncReturnCode::ReplAck )
	{
		uint8_t stereoMode = dab.MsgBuffer()[0];
		terminal.Send("StereoMode: ");
		terminal.Send(stereoMode);
		terminal.SendCRLF();
		return TaskReturn::Done;
	}
	else if ( ret == AsyncReturnCode::ReplyNack )
	{
		return TaskReturn::Done;
	}
	return TaskReturn::Fail;
}

static TaskInit funcUpdateVolume_init()
{
	if ( volumeSetting != nLastVolume )
	{
		if ( nLastVolume < volumeSetting )
			nLastVolume++;
		else if ( nLastVolume > volumeSetting )
			nLastVolume--;
		dab.STREAM_SetVolume_Async( nLastVolume, ms );

		terminal.Send("Volume=");
		terminal.Send(nLastVolume);
		terminal.SendCRLF();

		return TaskInit::OK;
	}
	return TaskInit::Skip;
}

TaskReturn funcUpdateVolume_check(AsyncReturnCode ret )
{
	return TaskReturn::Done;
}

void InitPollTasks(uint8_t nLevel)
{
	task = 0;
	nTaskCount = 0;

	// every second - radio play status, volume
	// every 15 seconds - play mode, play index, signal strength, program text
	// every 5 minutes - clock

	if ( nLevel >= 1 )
	{
		TaskList[nTaskCount++] = { funcChangeProgram_init, ack_check };
		TaskList[nTaskCount++] = { funcGetPlayStatus_init, funcGetPlayStatus_check };
		TaskList[nTaskCount++] = { funcUpdateVolume_init, funcUpdateVolume_check };
	}
	if ( nLevel >= 2 )
	{
		TaskList[nTaskCount++] = { funcGetPlayMode_init, funcGetPlayMode_check };
		TaskList[nTaskCount++] = { funcGetPlayIndex_init, funcGetPlayIndex_check };
		TaskList[nTaskCount++] = { funcGetSignalStrength_init, funcGetSignalStrength_check };
		TaskList[nTaskCount++] = { funcGetStereo_init, funcGetStereo_check };
		TaskList[nTaskCount++] = { funcGetProgramText_init, funcGetProgramText_check };

#ifndef SET_CLOCK_AT_POWERUP
		//if ( !bClockInitialised )
		{
			TaskList[nTaskCount++] = { funcGetClockStatus_init, funcGetClockStatusOptional_check };
			TaskList[nTaskCount++] = { funcGetClock_init, funcGetClock_Optional_check };
		}
#endif

	}
	if ( nLevel >= 3 )
	{
		TaskList[nTaskCount++] = { funcEnableSyncClock_init, ack_check };
		TaskList[nTaskCount++] = { funcGetClockStatus_init, funcGetClockStatusOptional_check };
		TaskList[nTaskCount++] = { funcGetClock_init, funcGetClock_Optional_check };
	}
}

int8_t NextTask()
{
	task++;
	if ( task >= nTaskCount )
		task = -1;
	return task;
}

static uint32_t playPollTimer = 0;


void DoDAB()
{
	{
		static RadioState lastState = RadioState::Init;
		if ( lastState != radioState )
		{
			terminal.Send((uint8_t)lastState);
			terminal.Send("->");
			terminal.Send((uint8_t)radioState);
			terminal.SendCRLF();
			lastState = radioState;
		}
	}
	AsyncReturnCode ret = dab.Async( ms );
	if ( ret != AsyncReturnCode::OK )
	{
		terminal.Send("ret="); terminal.Send((uint8_t)ret); terminal.SendCRLF();
	}
	if ( dab.isIdle() )
	{
		switch ( radioState )
		{
			case RadioState::Init:
				//dab.AsyncStart();
				dab.SYSTEM_GetSysRdy_Async(ms,500);
				SetWaitForReply( RadioState::InitStartUpTasks, RadioState::Init );
				//SetWaitForReply( RadioState::Idle, RadioState::Init );
				break;

			case RadioState::WaitForReply:
				if ( ret == AsyncReturnCode::ReplAck )
					radioState = successState;
				else if ( ret != AsyncReturnCode::OK )
					radioState = failState;
				break;

			case RadioState::InitStartUpTasks:
				InitStartUpTasks();
				radioState = RadioState::StartUpTasks;
				taskDoneState = RadioState::Off;
				break;

			case RadioState::StartUpTasks:
			{
				// Next task
				TaskInit t = TaskList[task].init();
				terminal.Send("Task="); terminal.Send((int)task); terminal.SendCRLF();
				if ( t == TaskInit::OK || t == TaskInit::Skip )
				{
					if ( t == TaskInit::Skip || TaskList[task].check == NULL )
					{
						task = NextTask();
						if ( task < 0 )
							radioState = taskDoneState;	// Done.
					}
					else
					{
						radioState = RadioState::WaitForTaskReply;
					}
				}
			}
				break;
				
			case RadioState::WaitForTaskReply:
				if ( ret != AsyncReturnCode::OK )
				{
					TaskReturn tret = TaskReturn::Done;
					if ( TaskList[task].check != NULL )
						tret = TaskList[task].check(ret);
					if ( tret == TaskReturn::Done )
					{
						task = NextTask();
						if ( task < 0 )
							radioState = taskDoneState;	// Done.
						else
							radioState = RadioState::StartUpTasks;
					}
					else if ( tret == TaskReturn::Continue )
					{
						radioState = RadioState::StartUpTasks;
					}
					else 
					{
						radioState = RadioState::StartUpTasksPause;
						radioTimer = ms + 250;
					}
				}
			break;

			case RadioState::StartUpTasksPause:
				if ( (int32_t)radioTimer - (int32_t)ms <= 0 )
					radioState = RadioState::StartUpTasks;
				break;

			case RadioState::StartPlaying:
				dab.SYSTEM_GetSysRdy_Async(ms,500);
				SetWaitForReply( RadioState::InitStartTasks, RadioState::StartPlaying );
				break;
								
			case RadioState::StartScanning:
				dab.SYSTEM_GetSysRdy_Async(ms,500);
				SetWaitForReply( RadioState::InitScanTasks, RadioState::StartScanning );
				break;
								
			case RadioState::InitScanTasks:
				InitScanTasks();
				radioState = RadioState::StartUpTasks;
				taskDoneState = RadioState::ScanDone;
				break;

			case RadioState::ScanDone:
				RadioOff();
				break;

			case RadioState::InitStartTasks:
				InitStartTasks();
				dab.Mute( false );
				radioState = RadioState::StartUpTasks;
				taskDoneState = RadioState::Playing;
				break;

			case RadioState::PlayingNext:
				radioState = RadioState::Playing;
				playPollTimer = ms + 1000;
				break;

			case RadioState::Playing:
				if ( ret == AsyncReturnCode::Notification )
				{
					// TODO - decide - do we continue with this?  Even after receiving the notification, programme text is not there.
					if ( dab.LastNotification() == DABNotificationType::NewProgrammeText )
					{
						InitGetProgramTextTasks();
						radioState = RadioState::StartUpTasks;
						taskDoneState = RadioState::Playing;
					}
					else
					{
						terminal.Send("Notification: ");
						terminal.Send( (uint8_t)ret);
						terminal.SendCRLF();
					}
				}
				else
				{

					// Execute Scheduled task lists
					// every second - radio play status, volume
					// every 15 seconds - play mode, play index, signal strength, program text
					// every 5 minutes - clock
					if ( (int32_t)playPollTimer - (int32_t)ms <= 0 )
					{
						const uint16_t LONG_TIME = 5*60;	// clock every 5 minutes.
						const uint16_t SHORT_TIME = 10;		// clock every 15 seconds.
						static uint16_t nTicker = LONG_TIME - 30;
						if ( nTicker == LONG_TIME )
						{
							InitPollTasks(3);
							nTicker = 0;
						}
						else if ( nTicker % SHORT_TIME == 0 )
							InitPollTasks(2);
						else
							InitPollTasks(1);

						nTicker++;
						radioState = RadioState::StartUpTasks;
						taskDoneState = RadioState::PlayingNext;
					}
				}
				break;

			case RadioState::Off:
				break;
		}
	}
}

static void DrawSignalStength( uint8_t strength )
{
	const int STRENGTH_BARS = 9;
	const int BAR_WIDTH = 2;
	const int BAR_SPACING = 1;
	const int BAR_ON_COLOUR = 0x3F;
	const int BAR_OFF_COLOUR = 0x4;
	const int BUFFER_WIDTH = (BAR_WIDTH+BAR_SPACING) * STRENGTH_BARS;
	const int BUFFER_WIDTH_WORDS = BUFFER_WIDTH / 3;

	if ( displayMode == DisplayMode::Playing )
	{
		lastSignalStrength = strength;

		// dab strength is 0-16 (18?)
		div_t d = div(STRENGTH_BARS * strength, 16);
		uint8_t strengthBars = d.quot + (d.rem > 16/2 ? 1 : 0);	// Round 

		uint16_t buffer[ (BAR_WIDTH+BAR_SPACING) * STRENGTH_BARS * STRENGTH_BARS / 3 ];
		memset( buffer, 0, sizeof(buffer) );

		for ( uint8_t b = 0; b < STRENGTH_BARS; b++ )
		{
			uint8_t c = (b < strengthBars) ? BAR_ON_COLOUR : BAR_OFF_COLOUR;
			for ( uint8_t i = 0; i <= b; i++ )
			{
				uint8_t x = b * (BAR_WIDTH+BAR_SPACING);
				uint8_t y = STRENGTH_BARS-1 - i;

				uint16_t *p = buffer + x/3 + y*BUFFER_WIDTH_WORDS;
				SetPixel( p, c, x % 3 );
				x++;
				p = buffer + x/3 + y*BUFFER_WIDTH_WORDS;
				SetPixel( p, c, x % 3 );
			}
		}

		display.SetRow( ROW_HEIGHT, ROW_HEIGHT+STRENGTH_BARS-1 );
		display.SetColumn( (OP_SCREENW - BUFFER_WIDTH)/3, OP_SCREENW/3 - 1 );
		display.sendData( buffer, countof(buffer));
	}
}

static void DrawPlayingMode()
{
	display.clearScreen(true);
	ShowDate();
	ShowProgram();
	DrawSignalStength( 0 );
}

static void ChangeDisplayMode( DisplayMode mode )
{
	displayMode = mode;
	switch ( displayMode ) 
	{
		case DisplayMode::Playing:
			DrawPlayingMode();
			break;
		default:
			break;
	}
}


static void SetPixel( uint16_t *pixel, uint8_t c, uint8_t nPos )
{
	switch ( nPos )
	{
		case 0:	
			*pixel |= (c>>1) << 11;
			break;
		case 1:
			*pixel |= c << 5;
			break;
		case 2:
			*pixel |= c>>1;
			break;
	}
}


// Write text to memory buffer.  Optimised version - minimal bounds checking.
void WriteText( int16_t x, int8_t y, const char *s, uint8_t slen, uint16_t plen )
{
	const FontStruct * font = &font_6x13;
	const uint8_t colour = 0x3f;

	// On the screen?
	if ( y + font->rows < 0 || y > TUNER_WIDTH )
		return;

	// Because each pixel is made up of 3 dots, we need to shift the physical start/end to 3 pixel boundaries.
	div_t start = div(x,3);

	if ( start.rem < 0 )
		start.rem += 3;
	for ( uint8_t row = 0; row < font->rows; row++, y++ )
	{
		if ( y >=0 && y < OP_SCREENH )
		{
			const char *ptr = s;
			uint8_t p = start.rem;
			uint16_t *screen = paintBuffer + y * TUNER_WIDTH_WORDS + start.quot;

			// text
			while ( *ptr )
			{
				uint8_t bits = pgm_read_byte( font->data + (*ptr - font->first_char) * font->rows + row );
				for ( uint8_t c = 0; c < font->cols; c++ )
				{
					SetPixel( screen, (bits & _BV(7-c)) ? colour : 0, p );
					p++;
					if (p==3) 
					{	
						p = 0;
						screen++;
					}
				}
				ptr++;
				p++;
				if (p==3)
				{
					p = 0;
					screen++;
				}
			}
		}
	}
}

void DrawTuner()
{
	uint16_t buffer[TUNER_WIDTH_WORDS * OP_SCREENH ];
	paintBuffer = buffer;
	memset( buffer, 0, sizeof(buffer) );

	// nTunerPosition is the "pixel" offset to the program we want to display.
	// ie 0 - program 0, 12 = program 1, etc (12=ROW_HEIGHT).
	// 0 is 0 pixels from the middle of the screen row.

	int8_t y = OP_SCREENH /2 - ROW_HEIGHT/2;
	div_t program = div(nTunerPosition, ROW_HEIGHT );
	int16_t program0 = program.quot;
	int8_t dy = program.rem;

	for ( int16_t n = -2; n <= 2; n++ )
	{
		uint16_t nProg = program0+n;
		int16_t nProgY = y+n*ROW_HEIGHT-dy;
		if ( nProg >= 0 && nProg < nPrograms )
		{
			uint8_t slen = strlen( programs[nProg].sLongName );
			uint16_t plen = slen * (font_6x13.cols+1) - 1;
			WriteText( TUNER_WIDTH/2-plen/2,nProgY, programs[nProg].sLongName, slen, plen );
		}
	}
	// Selection box is always in the middle
	uint16_t *pStart = buffer + (OP_SCREENH /2 - ROW_HEIGHT/2 - 1)*TUNER_WIDTH_WORDS;
	uint16_t *pEnd = pStart + (ROW_HEIGHT)*TUNER_WIDTH_WORDS;
	while ( pStart < pEnd )
	{
		*pStart = ~*pStart;
		pStart++;
	}

	display.SetRow();
	display.SetColumn((OP_SCREENW/2-TUNER_WIDTH/2)/3,(OP_SCREENW/2+TUNER_WIDTH/2)/3-1);
	display.sendData( buffer, countof(buffer) );
}

void InitTunerDisplay()
{
	display.clearScreen(false);

	nTunerPosition = settings.nLastPlayedProgramIndex * ROW_HEIGHT;	// We use pixel scrolling postions
	nTunerTarget = nTunerPosition;

	DrawTuner();
}


void UpdateTunerDisplay(int8_t nEncoderDelta)
{
	static uint8_t nChannelChange = 0;
	static uint8_t nInactiveTimer = 0;

	const uint8_t CHANNEL_CHANGE_TIMER = (1280/128);	// ms/128
	const uint8_t INACTIVE_TIMER = (7500l/128);			// ms/128

	while ( nEncoderDelta > 0 )
	{
		nTunerTarget += ROW_HEIGHT;
		nEncoderDelta--;
		nChannelChange = CHANNEL_CHANGE_TIMER;
		nInactiveTimer = INACTIVE_TIMER;
	}
	while ( nEncoderDelta < 0 )
	{
		if ( nTunerTarget < ROW_HEIGHT )
			nTunerTarget = 0;
		else
			nTunerTarget -= ROW_HEIGHT;
		nEncoderDelta++;
		nChannelChange = CHANNEL_CHANGE_TIMER;
		nInactiveTimer = INACTIVE_TIMER;
	}

	if ( nTunerTarget  > ROW_HEIGHT*(nPrograms-1) )
		nTunerTarget  = ROW_HEIGHT*(nPrograms-1);

	static uint8_t last_ms8 = 0;
	uint8_t ms8 = *(uint8_t *)&ms;
	if ( ms8 != last_ms8 )
	{
		last_ms8 = ms8;

		if ( (ms8 & 0x7f) == 0 )	// every 128ms
		{
			if ( nChannelChange )
			{
				nChannelChange--;
				if ( nChannelChange == 0 )
				{
					nNextProgram = nTunerTarget / ROW_HEIGHT;
				}
			}
			if ( nInactiveTimer )
			{
				nInactiveTimer--;
				if ( nInactiveTimer == 0 )
				{
					ChangeDisplayMode( DisplayMode::Playing );
				}
			}
		}
	}

	if ( nTunerTarget == nTunerPosition )
		return;

	if ( nTunerPosition < nTunerTarget )
		nTunerPosition++;
	else if ( nTunerPosition > nTunerTarget )
		nTunerPosition--;

	DrawTuner();
}

static void Tuner( int8_t nEncoder )
{
	switch ( displayMode )
	{
		case DisplayMode::Off:
			break;
		case DisplayMode::Menu:
			break;
		case DisplayMode::Playing:
			// Move from Playing display to Tuner (select program)
			InitTunerDisplay();
			displayMode = DisplayMode::Tuner;
			break;
		case DisplayMode::Tuner:
			UpdateTunerDisplay(nEncoder);
			break;
		case DisplayMode::Scanning:
			break;
		}
}

static void RadioPlay()
{
	if ( radioState == RadioState::Off )
	{
		dab.AsyncStart();
		displayMode = DisplayMode::Playing;
		display.InitDisplay();
		ShowDate();
		DrawSignalStength( 0 );
		radioState = RadioState::StartPlaying;
		clockRadioState = ClockRadioState::Idle;
	}
}

static void RadioSleep()
{
	RadioPlay();
	bAlarmOn = true;	// fake alarm
	nAlarmOffTime = clock_secs + settings.nSleepTime*60;
}


static void RadioOff(bool bForce)
{
	if ( radioState != RadioState::Off || bForce )
	{
		dab.PowerOff();
		display.displayPowerOff();
		bDABClockEnabled = false;
		radioState = RadioState::Off;
		clockRadioState = ClockRadioState::Off;
		*sCurrentProgramText = 0;
		bAlarmOn = false;
	}
}

static bool DrawProgramText(bool bNewText)
{
	bool bShifting = false;
	uint8_t len = strlen(sCurrentProgramText);

	if ( bNewText )
	{
		textXShift = 0;
		uint16_t plen = len * (font_6x13.cols+1);
		if ( plen <= OP_SCREENW )
		{
			// Small enough to fit on the screen.
			xoffs = (OP_SCREENW - plen) / 2;
		}
		else 
		{
			xoffs = -1;
			textXShiftMax = plen - OP_SCREENW;
		}
	}
	if ( xoffs >= 0 )
	{
		if ( bNewText )
			display.WriteText( &font_6x13, xoffs, PROGRAM_TEXT_POS, sCurrentProgramText);
	}
	else 
	{
		if ( textXShift < textXShiftMax )
		{
			div_t offs = div( textXShift, font_6x13.cols+1 );

			display.WriteText( &font_6x13, -offs.rem, PROGRAM_TEXT_POS, sCurrentProgramText+offs.quot);
			textXShift++;
			bShifting = true;
		}
	}
	return bShifting;
}

static enum class ScrollState: uint8_t
{
	idle,
	shiftingOut,
	startNew,
	pause,
	scroll
} scrollState = ScrollState::idle, scrollNextState;
uint32_t scrollDelay;

static void ScrollText(bool bRedraw)
{
	static uint8_t nShiftCount = 0;
	static uint8_t last_ms8 = 0;
	uint8_t ms8 = *(uint8_t *)&ms;

	if ( bRedraw )
	{
		strncpy( sCurrentProgramText, sProgramNames, sizeof(sCurrentProgramText) );
		sCurrentProgramText[sizeof(sCurrentProgramText)-1] = '\0';
		nShiftCount = font_6x13.rows+1;
		scrollState = ScrollState::shiftingOut;
	}
	if ( ms8 != last_ms8 && displayMode == DisplayMode::Playing )
	{
	if ( (ms8 & 7) == 0 )
		switch ( scrollState )
		{
			case ScrollState::idle:
				break;

			case ScrollState::shiftingOut:
				// Are we shifting the text away.
				if ( nShiftCount && (ms8 & 0x3f) == 0 )
				{
					uint16_t xs =0;
					uint8_t ys = PROGRAM_TEXT_POS-1+font_6x13.rows-(nShiftCount-1);
					uint16_t xe = OP_SCREENW-1;
					uint8_t ye = PROGRAM_TEXT_POS+font_6x13.rows;
					uint16_t xd=0;
					uint8_t yd = ys+1;

					display.Copy( xs,ys, xe,ye, xd,yd );
					nShiftCount--;
					if ( nShiftCount == 0 )
						scrollState = ScrollState::startNew;
				}
				break;

			case ScrollState::startNew:
				{
					uint16_t xe = OP_SCREENW-1;
					uint16_t xd=0;
					uint8_t yd = PROGRAM_TEXT_POS-1+font_6x13.rows;

					display.ClearWindow( xd,yd, xe,yd+1 );

					if ( DrawProgramText(true) )
					{
						scrollDelay = ms + 3000;
						scrollState = ScrollState::pause;
						scrollNextState = ScrollState::scroll;
					}
					else
						scrollState = ScrollState::idle;
				}
				break;

			case ScrollState::pause:
				if ( (int32_t)scrollDelay - (int32_t)ms < 0 )
				{
					scrollState = scrollNextState;
				}
				break;

			case ScrollState::scroll:
				if ( !DrawProgramText(false) )
				{
					nShiftCount = font_6x13.rows+1;
					scrollDelay = ms + 3000;
					scrollState = ScrollState::pause;
					scrollNextState = ScrollState::shiftingOut;
				}
				break;
		}
		last_ms8 = ms8;
	}

}

//alarms
	//* Alarm 1
		//* enabled one off - day month year hh mktime
		//* enabled scheduled - SMTWTFS HH MM
	//* Alarm 2
//Alarm Time
//Snooze Time
//Sleep Time
//Rescan DAB
/*
123456789012345678901234567890123456789012345678
Alarm 1 : Off
Alarm 2 : 12 Feb 2016 07:15 am
Alarm 3 : Sun Mon Tue Wed Thu Fri Sat 07:15 am
Alarm On Time: MMM min
Snooze Time: MMM min
Sleep Time: MMM min
Rescan DAB:
*/


static uint8_t iMenuItem;
static uint8_t bEditing;

enum class MenuType : uint8_t
{
	Button,
	Integer8,
	Alarm
};

struct Menu
{
	MenuType type;
	const char *sDesc;
	void (* DrawMenu)( uint8_t data, uint16_t x, uint8_t y );
	int DrawMenuData;
	void (* DoMenu)( uint8_t data, uint16_t x, uint8_t y, bool bFirst, uint16_t key_changes, int16_t nEncoder );
}; 

static void Make2Int( char *s, uint8_t n, char cFiller=' ' )
{
	if ( n >= 100 )
		n = n % 100;

	if ( n < 10 )
		*(s++) = cFiller;
	itoa( n, s, 10 );
}

static void Make3Int( char *s, uint8_t n )
{
	if ( n < 100 )
	{
		*(s++) = ' ';
		if ( n < 10 )
		*(s++) = ' ';
	}
	itoa( n, s, 10 );
}

/*
123456789012345678901234567890123456789012345678
Alarm 1 : Off
Alarm 2 : Mon 12 Feb 2016 07:15 am
Alarm 3 : Sun Mon Tue Wed Thu Fri Sat 07:15 am
*/

#define DOW_BACKGROUND_COLOUR 24

void ShowAlarmDOW( uint8_t dow, uint8_t iEnabled, uint16_t x, uint8_t y )
{
	display.WriteText( &font_6x13, x, y, WeekDay[dow], iEnabled == 0 ? 0x3F : 0, iEnabled == 0 ? 0 : DOW_BACKGROUND_COLOUR );
}

void DrawAlarm( Alarm &alarm,uint16_t x,uint8_t y)
{
	char line[36];
	char *p = line;
	memset( line, ' ', sizeof(line) );
	line[sizeof(line)-1] = 0;

	switch ( alarm.type )
	{
		case AlarmType::Off:
		default:
			*p++ = 'O';
			*p++ = 'f';
			*p++ = 'f';
			display.WriteText(&font_6x13, x,y, line );
			break;

		case AlarmType::OneOff:
		{
			struct tm t;

			t.tm_hour = alarm.nHour%12;
			if ( alarm.nAmPm )
				t.tm_hour += 12;
			t.tm_min = alarm.nMin;
			t.tm_sec = 0;
			t.tm_mday = alarm.nDay;
			t.tm_mon = alarm.nMonth;
			t.tm_year = alarm.nYear - 1900;
			mktime(&t);
		
			char *p = line;
			*p++ = WeekDay[t.tm_wday][0];
			*p++ = WeekDay[t.tm_wday][1];
			*p++ = WeekDay[t.tm_wday][2];
			*p++ = ' ';
			Make2Int( p, alarm.nDay ); p+=2;
			*p++ = ' ';
			*p++ = Month[alarm.nMonth][0];
			*p++ = Month[alarm.nMonth][1];
			*p++ = Month[alarm.nMonth][2];
			*p++ = ' ';
			uint16_t year = alarm.nYear - 2000;
			*p++ = '2';
			*p++ = '0' + (year%1000)/100;
			*p++ = '0' + (year%100)/10;
			*p++ = '0' + (year%10);
			*p++ = ' ';
			Make2Int( p, alarm.nHour );
			p+=2;
			*p++ = ':';
			Make2Int( p, alarm.nMin, '0' );
			p+=2;
			if ( alarm.nAmPm )
				*p++ = 'p';
			else
				*p++ = 'a';
			*p++ = 'm';
			display.WriteText( &font_6x13, x,y, line );
			break;
		}

		case AlarmType::Scheduled:
		{
			char *p = line;
			Make2Int( p, alarm.nHour );
			p+=2;
			*p++ = ':';
			Make2Int( p, alarm.nMin, '0' );
			p+=2;
			if ( alarm.nAmPm )
				*p++ = 'p';
			else
				*p++ = 'a';
			*p++ = 'm';
			display.WriteText( &font_6x13, x,y, line );
			
			for ( uint8_t dow = 0; dow < 7; dow++ )
			{
				ShowAlarmDOW( dow, alarm.dow & _BV(dow), x + (8 + 4 * dow ) * (font_6x13.cols+1), y);
			}
			break;
		}
	}
}

void DrawAlarm(uint8_t iAlarm,uint16_t x,uint8_t y)
{
	DrawAlarm(settings.Alarms[iAlarm],x,y);
}
void DrawMinutes( uint16_t x, uint8_t y, uint8_t n )
{
	char s[10];		// XXX min
	Make3Int( s, n );
	strcat(s, " min" );
	display.WriteText( &font_6x13, x, y, s );
}

void DrawUint8( uint16_t x, uint8_t y, uint8_t n )
{
	char s[10];		// XX
	Make2Int( s, n );
	display.WriteText( &font_6x13, x, y, s );
}

void DrawAlarmTime(uint8_t,uint16_t x,uint8_t y)
{
	DrawMinutes( x,y, settings.nAlarmRunTime );
}

void DrawSnoozeTime(uint8_t,uint16_t x,uint8_t y)
{
	DrawMinutes( x,y, settings.nSnoozeTime );
}

void DrawSleepTime(uint8_t,uint16_t x,uint8_t y)
{
	DrawMinutes( x,y, settings.nSleepTime );
}

void DrawTimeIntensity(uint8_t,uint16_t x,uint8_t y)
{
	DrawUint8( x,y, settings.nTimeIntensity );
}
void DrawDABIntensity(uint8_t,uint16_t x,uint8_t y)
{
	DrawUint8( x,y, settings.nDABIntensity );
}

static void DoRescanDAB(uint8_t,uint16_t x,uint8_t y, bool bFirst, uint16_t key_changes, int16_t nEncoder)
{
	display.clearScreen();
	dab.AsyncStart();
	displayMode = DisplayMode::Scanning;
	radioState = RadioState::StartScanning;
	clockRadioState = ClockRadioState::Idle;
}

enum class EditIntReturn : uint8_t
{
	Continue,
	OK,
	Cancel
};


static EditIntReturn EditInt(uint8_t *n,uint16_t x,uint8_t y, bool bFirst, uint16_t key_changes, int16_t nEncoder)
{
	static uint8_t dn;
	static uint16_t dx;
	static uint8_t dy;

	bool bRedraw = false;
	if ( bFirst )
	{
		dn = *n;
		dx = x;
		dy = y;
		bRedraw = true;
		bEditing = true;
	}
	if ( nEncoder )
	{
		if ( nEncoder < 0 && dn < abs(nEncoder) )
			dn = 0;
		else  if ( nEncoder > 0 && 255 - dn < nEncoder )
			dn = 255;
		else
			dn += nEncoder;
		bRedraw = true;
	}
	if ( bRedraw )
	{
		DrawMinutes( dx, dy, dn );
	}
	if ( key_changes & keydown & (BTN_ALARM1 | BTN_ALARM2) )
	{
		*n = dn;
		bEditing = false;
		DrawMenu();
		return EditIntReturn::OK;
	}
	return EditIntReturn::Continue;
}

// eek - copy and paste
static EditIntReturn EditUInt8(uint8_t *n,uint16_t x,uint8_t y, bool bFirst, uint16_t key_changes, int16_t nEncoder, uint8_t max)
{
	static uint8_t dn;
	static uint16_t dx;
	static uint8_t dy;

	bool bRedraw = false;
	if ( bFirst )
	{
		dn = *n;
		dx = x;
		dy = y;
		bRedraw = true;
		bEditing = true;
	}
	if ( nEncoder )
	{
		if ( nEncoder < 0 && dn < abs(nEncoder) )
			dn = 0;
		else  if ( nEncoder > 0 && max - dn < nEncoder )
			dn = max;
		else
			dn += nEncoder;
		bRedraw = true;
	}
	if ( bRedraw )
	{
		DrawUint8( dx, dy, dn );
	}
	if ( key_changes & keydown & (BTN_ALARM1 | BTN_ALARM2) )
	{
		*n = dn;
		bEditing = false;
		DrawMenu();
		return EditIntReturn::OK;
	}
	return EditIntReturn::Continue;
}

static void EditAlarmTime(uint8_t,uint16_t x,uint8_t y, bool bFirst, uint16_t key_changes, int16_t nEncoder)
{
	if ( EditInt(&settings.nAlarmRunTime,x,y,bFirst,key_changes,nEncoder) == EditIntReturn::OK )
	{
		WriteEEPROM();
	}
}
static void EditSnoozeTime(uint8_t,uint16_t x,uint8_t y, bool bFirst, uint16_t key_changes, int16_t nEncoder)
{
	if ( EditInt(&settings.nSnoozeTime,x,y,bFirst,key_changes,nEncoder) == EditIntReturn::OK )
	{
		WriteEEPROM();
	}
}
static void EditSleepTime(uint8_t,uint16_t x,uint8_t y, bool bFirst, uint16_t key_changes, int16_t nEncoder)
{
	if ( EditInt(&settings.nSleepTime,x,y,bFirst,key_changes,nEncoder) == EditIntReturn::OK )
	{
		WriteEEPROM();
	}
}
static void EditTimeIntensity(uint8_t,uint16_t x,uint8_t y, bool bFirst, uint16_t key_changes, int16_t nEncoder)
{
	if ( EditUInt8(&settings.nTimeIntensity,x,y,bFirst,key_changes,nEncoder, 16) == EditIntReturn::OK )
	{
		sevenSeg_I2C.SetBrightness(settings.nTimeIntensity);
		WriteEEPROM();
	}
}

static void EditDABIntensity(uint8_t,uint16_t x,uint8_t y, bool bFirst, uint16_t key_changes, int16_t nEncoder)
{
	if ( EditUInt8(&settings.nDABIntensity,x,y,bFirst,key_changes,nEncoder, 15) == EditIntReturn::OK )
	{
		display.setBrightness(settings.nDABIntensity);
		WriteEEPROM();
	}
}
static void ExitMenu()
{
	RadioOff(true);
}


enum class EditAlarmField : uint8_t
{
	Type,

	SchHour,
	SchMin,
	SchAmPm,
	SchSun,
	SchMon,
	SchTue,
	SchWed,
	SchThu,
	SchFri,
	SchSat,

	OODay,
	OOMonth,
	OOYear,
	OOHour,
	OOMin,
	OOAmPm,

	Complete
};

static EditAlarmField editAlarmState;

static void EditAlarmType(Alarm &alarm,uint16_t x,uint8_t y, int16_t nEncoder)
{
	uint8_t n = (uint8_t)alarm.type;
		
	if ( nEncoder )
	{
		if ( nEncoder < 0 && n < abs(nEncoder) )
			n = 0;
		else  if ( nEncoder > 0 && (uint8_t)AlarmType::Max - 1 - n < nEncoder )
			n = (uint8_t)AlarmType::Max - 1;
		else
			n += nEncoder;

		if ( n != (uint8_t)alarm.type )
		{
			alarm.type = (AlarmType)n;
			DrawAlarm( alarm, x, y );
		}
	}
}

static void EditAlarmInt2(bool bFirst,uint16_t x, uint8_t y, uint8_t *n, Alarm &alarm, char fill, uint8_t min, uint8_t max, int8_t nEncoder) 
{
	bool bRedraw = false;
	if ( bFirst )
	{
		bRedraw = true;
	}
	if ( nEncoder )
	{
		while ( nEncoder < 0 )
		{
			if ( *n > min )
				(*n)--;
			nEncoder++;
		}
		while ( nEncoder > 0 )
		{
			if ( *n < max )
				(*n)++;
			nEncoder--;
		}
		bRedraw = true;
	}
	if ( bRedraw )
	{
		char s[5];
		Make2Int( s, *n, fill );
		display.WriteText( &font_6x13, x, y, s, 0, 0x3F );
	}
}

static void EditAlarmInt4(bool bFirst,uint16_t x, uint8_t y, uint16_t *n, Alarm &alarm, uint16_t min, uint16_t max, int8_t nEncoder)
{
	bool bRedraw = false;
	if ( bFirst )
	{
		bRedraw = true;
	}
	if ( nEncoder )
	{
		while ( nEncoder < 0 )
		{
			if ( *n > min )
			{
				bRedraw = true;
				(*n)--;
			}
			nEncoder++;
		}
		while ( nEncoder > 0 )
		{
			if ( *n < max )
			{
				bRedraw = true;
				(*n)++;
			}
			nEncoder--;
		}
	}
	if ( bRedraw )
	{
		char s[5];
		s[0] = '0' + *n/1000;
		s[1] = '0' + (*n%1000)/100;
		s[2] = '0' + (*n%100)/10;
		s[3] = '0' + (*n%10);
		s[4] = '\0';
		display.WriteText( &font_6x13, x, y, s, 0, 0x3f );
	}
}

const char *AmPm[] { "am", "pm" };

static void EditAlarmEnum(bool bFirst, uint16_t x, uint8_t y, uint8_t *n, Alarm &alarm, const char **data, uint8_t count, int8_t nEncoder) 
{
	bool bRedraw = false;

	if ( bFirst )
	{
		bRedraw = true;
	}

	if ( nEncoder )
	{
		while ( nEncoder > 0 )
		{
			if ( *n < count-1 )
			{
				(*n)++;
				bRedraw = true;
			}
			nEncoder--;
		}
		while ( nEncoder < 0 )
		{
			if ( *n > 0 )
			{
				(*n)--;
				bRedraw = true;
			}
			nEncoder++;
		}
	}
	if ( bRedraw )
	{
		display.WriteText( &font_6x13, x,y, data[*n], 0, 0x3f );
	}
}

static void EditAlarmDOW(bool bFirst,uint16_t x, uint8_t y, uint8_t *n, uint8_t dow, Alarm &alarm, int8_t nEncoder) 
{
	bool bRedraw = false;

	if ( bFirst )
	{
		bRedraw = true;
	}

	if ( nEncoder )
	{
		if ( nEncoder > 0 && (*n & _BV(dow)) == 0 )
		{
			*n |= _BV(dow);
			bRedraw = true;
		}
		else if ( nEncoder < 0 && (*n & _BV(dow)) != 0 )
		{
			*n &= ~_BV(dow);
			bRedraw = true;
		}
	}
	if ( bRedraw )
	{
		display.WriteText( &font_6x13, x,y, WeekDay[dow], 0x3F, (*n & _BV(dow)) ? DOW_BACKGROUND_COLOUR : 0 );
		display.HLine( x, x+(font_6x13.cols+1)*3, y+ROW_HEIGHT-1, 0xFF);
	}
}

EditAlarmField NextField(Alarm &alarm, EditAlarmField field)
{
	if ( alarm.type == AlarmType::OneOff )
	{
		switch ( field )
		{
			case EditAlarmField::Type:		return EditAlarmField::OODay;
			case EditAlarmField::OODay:		return EditAlarmField::OOMonth;
			case EditAlarmField::OOMonth:	return EditAlarmField::OOYear;
			case EditAlarmField::OOYear:	return EditAlarmField::OOHour;
			case EditAlarmField::OOHour:	return EditAlarmField::OOMin;
			case EditAlarmField::OOMin:		return EditAlarmField::OOAmPm;
			default:
			case EditAlarmField::OOAmPm:		return EditAlarmField::Complete;
		}
	}
	else if ( alarm.type == AlarmType::Scheduled )
	{
		switch ( field )
		{
			case EditAlarmField::Type:		return EditAlarmField::SchHour;
			case EditAlarmField::SchHour:	return EditAlarmField::SchMin;	
			case EditAlarmField::SchMin:	return EditAlarmField::SchAmPm;	
			case EditAlarmField::SchAmPm:	return EditAlarmField::SchSun;
			case EditAlarmField::SchSun:	return EditAlarmField::SchMon;	
			case EditAlarmField::SchMon:	return EditAlarmField::SchTue;	
			case EditAlarmField::SchTue:	return EditAlarmField::SchWed;	
			case EditAlarmField::SchWed:	return EditAlarmField::SchThu;	
			case EditAlarmField::SchThu:	return EditAlarmField::SchFri;	
			case EditAlarmField::SchFri:	return EditAlarmField::SchSat;	
			default:
			case EditAlarmField::SchSat:	return EditAlarmField::Complete;
		}
	}
	return EditAlarmField::Complete;
}

static void EditAlarm(uint8_t iAlarm,uint16_t _x,uint8_t _y, bool bFirst, uint16_t key_changes, int16_t nEncoder)
{
	static Alarm alarm;
	static uint16_t dx;
	static uint8_t dy;

	if ( bFirst )
	{
		editAlarmState = EditAlarmField::Type;
		dx = _x;
		dy = _y;
		alarm = settings.Alarms[iAlarm];
		display.ClearWindow(dx-font_6x13.cols-1,dy, dx + 36*(font_6x13.cols+1),dy+ROW_HEIGHT-2, true);
		DrawAlarm(alarm,dx,dy);
		bEditing = true;
	}

	if ( key_changes & keydown & BTN_TIME_SET )
	{
		ExitMenu();
		return;
	}
	if ( key_changes & keydown & BTN_ALARM2 )
	{
		switch ( editAlarmState )
		{
			case EditAlarmField::Type:
				if ( alarm.type == AlarmType::Off )
				{
					editAlarmState = EditAlarmField::Complete;
				} 
				else
				{
					editAlarmState = NextField(alarm,editAlarmState);
					bFirst = true;
				}
				break;
			default:
				DrawAlarm(alarm,dx,dy);
				display.HLine( dx, dx+(font_6x13.cols+1)*36, dy+ROW_HEIGHT-1, 0);
				editAlarmState = NextField(alarm,editAlarmState);
				bFirst = true;
				break;
		}
	}
	switch ( editAlarmState )
	{
		case EditAlarmField::Type:
			EditAlarmType(alarm,dx,dy,nEncoder);
			break;
		case EditAlarmField::OODay:
			EditAlarmInt2(bFirst,dx+4*(font_6x13.cols+1),dy,&alarm.nDay,alarm,' ', 1, 31, nEncoder);
			break;
		case EditAlarmField::OOMonth:	
			EditAlarmEnum(bFirst,dx+7*(font_6x13.cols+1),dy,&alarm.nMonth,alarm, Month, countof(Month), nEncoder);
			break;
		case EditAlarmField::OOYear:
			EditAlarmInt4(bFirst,dx+11*(font_6x13.cols+1),dy,&alarm.nYear,alarm, 2015, 2100, nEncoder);
			break;
		case EditAlarmField::OOHour:
			EditAlarmInt2(bFirst,dx+16*(font_6x13.cols+1),dy,&alarm.nHour,alarm,' ', 1, 12, nEncoder);
			break;
		case EditAlarmField::OOMin:
			EditAlarmInt2(bFirst,dx+19*(font_6x13.cols+1),dy,&alarm.nMin,alarm, '0', 0, 59, nEncoder);
			break;
		case EditAlarmField::OOAmPm:
			EditAlarmEnum(bFirst,dx+21*(font_6x13.cols+1),dy,&alarm.nAmPm,alarm, AmPm, countof(AmPm), nEncoder);
			break;
		case EditAlarmField::SchHour:	
			EditAlarmInt2(bFirst,dx,dy,&alarm.nHour,alarm,' ', 1, 12, nEncoder);
			break;
		case EditAlarmField::SchMin:
			EditAlarmInt2(bFirst,dx+3*(font_6x13.cols+1),dy,&alarm.nMin,alarm, '0', 0, 59, nEncoder);
			break;
		case EditAlarmField::SchAmPm:
			EditAlarmEnum(bFirst,dx+5*(font_6x13.cols+1),dy,&alarm.nAmPm,alarm, AmPm, countof(AmPm), nEncoder);
			break;
		case EditAlarmField::SchSun:
			EditAlarmDOW(bFirst,dx+8*(font_6x13.cols+1),dy,&alarm.dow,0,alarm, nEncoder);
			break;
		case EditAlarmField::SchMon:
			EditAlarmDOW(bFirst,dx+12*(font_6x13.cols+1),dy,&alarm.dow,1,alarm, nEncoder);
			break;
		case EditAlarmField::SchTue:
			EditAlarmDOW(bFirst,dx+16*(font_6x13.cols+1),dy,&alarm.dow,2,alarm, nEncoder);
			break;
		case EditAlarmField::SchWed:
			EditAlarmDOW(bFirst,dx+20*(font_6x13.cols+1),dy,&alarm.dow,3,alarm, nEncoder);
			break;
		case EditAlarmField::SchThu:
			EditAlarmDOW(bFirst,dx+24*(font_6x13.cols+1),dy,&alarm.dow,4,alarm, nEncoder);
			break;
		case EditAlarmField::SchFri:
			EditAlarmDOW(bFirst,dx+28*(font_6x13.cols+1),dy,&alarm.dow,5,alarm, nEncoder);
			break;
		case EditAlarmField::SchSat:
			EditAlarmDOW(bFirst,dx+32*(font_6x13.cols+1),dy,&alarm.dow,6,alarm, nEncoder);
			break;
		case EditAlarmField::Complete:
			bEditing = false;
			settings.Alarms[iAlarm] = alarm;
			WriteEEPROM();
			PrimeAlarms();
			DrawMenu();
			break;
	}
}



Menu menu[] =
{
	{ type: MenuType::Alarm,	sDesc: "Alarm 1:",		DrawAlarm, 0,		EditAlarm },
	{ type: MenuType::Alarm,	sDesc: "Alarm 2:",		DrawAlarm, 1,		EditAlarm },
	{ type: MenuType::Alarm,	sDesc: "Alarm 3:",		DrawAlarm, 2,		EditAlarm },
	{ type: MenuType::Alarm,	sDesc: "Alarm 4:",		DrawAlarm, 3,		EditAlarm },
	{ type: MenuType::Integer8, sDesc: "Alarm Time: ",	DrawAlarmTime, 0,	EditAlarmTime },
	{ type: MenuType::Integer8, sDesc: "Snooze Time:",  DrawSnoozeTime, 0,	EditSnoozeTime },
	{ type: MenuType::Integer8, sDesc: "Sleep Time: ",	DrawSleepTime, 0,	EditSleepTime },
	{ type: MenuType::Button,	sDesc: "Rescan DAB",	NULL, 0,			DoRescanDAB },
	{ type: MenuType::Integer8, sDesc: "Time Intensity:",	DrawTimeIntensity, 0,	EditTimeIntensity},
	{ type: MenuType::Integer8, sDesc: "DAB Intensity :",	DrawDABIntensity,  0,	EditDABIntensity },
};


static void HighlightSelectedRow(int8_t nLastRow)
{
	if ( nLastRow >= 0 )
	{
		uint8_t iSelectedRow = nLastRow % 4;
		display.InvertWindow( 0,iSelectedRow*ROW_HEIGHT, OP_SCREENW-1,(iSelectedRow+1)*ROW_HEIGHT-2, true );
	}
	uint8_t iSelectedRow = iMenuItem % 4;
	display.InvertWindow( 0,iSelectedRow*ROW_HEIGHT, OP_SCREENW-1,(iSelectedRow+1)*ROW_HEIGHT-2, true );
}


static void DrawMenu()
{
	display.clearScreen(true);
	uint8_t iStart = (iMenuItem / 4) * 4;
	for ( uint8_t i = 0; i < 4 && i+iStart < countof(menu); i++ )
	{
		uint16_t x = 6;
		uint8_t y = ROW_HEIGHT * i;
		display.WriteText( &font_6x13, x, y, menu[i+iStart].sDesc );
		if ( menu[i+iStart].DrawMenu )
		{
			x += (strlen( menu[i+iStart].sDesc ) + 1) * (font_6x13.cols+1);
			menu[i+iStart].DrawMenu( menu[i+iStart].DrawMenuData, x, y );
		}
	}
	HighlightSelectedRow(-1);
}

static void StartMenu()
{
	clockRadioState = ClockRadioState::Menu;
	iMenuItem = 0;
	bEditing = false;
	display.InitDisplay();
	DrawMenu();
}


static void UpdateMenu(uint16_t key_changes, int8_t nEncoder )
{
	if ( !bEditing )
	{
		if ( nEncoder )
		{
			uint8_t iLastMenuItem = iMenuItem;
			while ( nEncoder > 0 )
			{
				if ( iMenuItem < countof(menu)-1 )
					iMenuItem++;
				nEncoder--;
			}
			while ( nEncoder < 0 )
			{
				if ( iMenuItem > 0 )
					iMenuItem--;
				nEncoder++;
			}

			if ( iMenuItem != iLastMenuItem )
			{
				if ( iMenuItem/4 == iLastMenuItem/4 )
					HighlightSelectedRow( iLastMenuItem );
				else
					DrawMenu();
			}
		}
		else if ( key_changes & keydown & (BTN_ALARM1 | BTN_ALARM2) )
		{
			uint16_t x = 6;
			uint8_t y = ROW_HEIGHT * (iMenuItem % 4);
			x += (strlen( menu[iMenuItem].sDesc ) + 1) * (font_6x13.cols+1);
			
			menu[iMenuItem].DoMenu( menu[iMenuItem].DrawMenuData, x,y, true, 0, 0);
		}
		else if ( key_changes & keydown & BTN_TIME_SET )
		{
			ExitMenu();
		}
	}
	else if ( bEditing )
	{
		menu[iMenuItem].DoMenu( menu[iMenuItem].DrawMenuData, 0,0, false, key_changes, nEncoder);
	}
}


static void DoClockRadio(uint16_t key_changes, int8_t nEncoder )
{
	switch ( clockRadioState )
	{
		case ClockRadioState::Off:
			if ( key_changes & keydown & BTN_RADIO_ON ) 
			{
				RadioPlay();
			}
			else if ( key_changes & keydown & BTN_SLEEP )
			{
				RadioSleep();
			}
			else if ( key_changes & keydown & BTN_TIME_SET )
			{
				StartMenu();
			}
			break;

		case ClockRadioState::Menu:
			UpdateMenu( key_changes, nEncoder );
			break;

		case ClockRadioState::Idle:
			if ( key_changes & keydown & BTN_SNOOZE && bAlarmOn )
			{
				AlarmOff();
				nNextAlarmDue = clock_secs + settings.nSnoozeTime*60;
			}
			if ( key_changes & keydown & BTN_RADIO_OFF )
			{
				RadioOff();
			}
			else if ( key_changes & keydown & BTN_TIME_SET )
			{
				ScrollText(true);
			}
			else if ( key_changes & keydown & (BTN_FWD_FAST | BTN_FWD_SLOW) )
			{
				if ( nNextProgram < nPrograms-1 )
					nNextProgram++;
				else
					nNextProgram = 0;
			}
			else if ( key_changes & keydown & (BTN_REV_FAST | BTN_REV_SLOW) )
			{
				if ( nNextProgram > 0 )
					nNextProgram--;
				else
					nNextProgram = nPrograms-1;
			}

			if ( nEncoder )
			{
				Tuner( nEncoder );
			}
			else
			{
				if ( displayMode == DisplayMode::Tuner )
				{
					Tuner(0);
				}
				ScrollText();
			}
			break;
	}
}

void Spinner()
{
	// sin/cos x/y coordinates of the dots. (spaced so the whitespace of the character doesn't touch the neighbouring dots)
	static struct { uint8_t x; uint8_t y; } pos[] = {
			{122,20},
			{125,10},
			{132,3},
			{142,0},
			{152,3},
			{159,10},
			{162,20},
			{159,30},
			{152,37},
			{142,40},
			{132,37},
			{125,30},
	};
	static uint8_t lc = 0;
	lc = (lc-1) & 0x3F;
	uint8_t c = lc;
	for ( uint8_t i = 0; i < countof(pos); i++ )
	{
		display.WriteText( &font_6x13, pos[i].x, pos[i].y, "\x7f", c );
		c += 0x3F/12;
		c = c & 0x3f;
	}
}

// Sliders are log pots, so convert them to near linear
static uint8_t ConvertVolume( int16_t v )
{
	static struct Samples
	{
		int16_t sample;
		int16_t diff;
	} sample[] = 
	{
		{190,5},
		{210,4},
		{225,4},
		{240,5},
		{260,10},
		{300,10},
		{340,10},
		{380,9},
		{415,19},
		{490,40},
		{650,63},
		{900,90},
		{1260,110},
		{1700,150},
		{2300,150},
		{2900,299},
		{4096,0},
	};

	// Use hysteresis to stop adc drifting.
	if ( nLastVolume == 0 && v < sample[0].sample + sample[0].diff )
		return nLastVolume;
	else if ( nLastVolume == countof(sample) && v > sample[countof(sample)-1].sample - sample[countof(sample)-1].diff )
		return nLastVolume;
	else if ( v > sample[nLastVolume-1].sample - sample[nLastVolume-1].diff &&  v < sample[nLastVolume-1].sample + sample[nLastVolume-1].diff )
		return nLastVolume;
		
	uint8_t d = 0;
	while ( sample[d].sample < v )
		d++;

	return d;
}

#ifdef NOEEPROM

static time_t MakeTime( uint8_t day, uint8_t month, uint8_t year, uint8_t hour, uint8_t min )
{
	struct tm t;
	memset( &t,0,sizeof(t));
	t.tm_mday = day;
	t.tm_mon = month;
	t.tm_year = year;
	t.tm_hour = hour;
	t.tm_min = min;
	t.tm_sec = 0;

	return mktime(&t);
}


static uint16_t MakeTime( uint8_t hour, uint8_t min )
{
	return hour * 24 + min;
}
#endif

static time_t NextTimeDue(const Alarm &alarm)
{
	time_t time = 0xFFFFFFFF;

	if ( bClockInitialised )
	{
		switch ( alarm.type )
		{
			case AlarmType::Max:
			case AlarmType::Off:
				break;

			case AlarmType::OneOff:
			{
				time_t t;
				struct tm nextTime;

				nextTime.tm_hour = alarm.nHour % 12;
				if ( alarm.nAmPm )
					nextTime.tm_hour += 12;
				nextTime.tm_min = alarm.nMin;
				nextTime.tm_sec = 0;
				nextTime.tm_mday = alarm.nDay;
				nextTime.tm_mon = alarm.nMonth;
				nextTime.tm_year = alarm.nYear - 1900;
				nextTime.tm_isdst = 0;
				t = mktime(&nextTime);

				if ( t < clock_secs )	// Gone
					time = 0;
				else
					time = t;
				break;
			}
			case AlarmType::Scheduled:
				{
					struct tm tm_time;
					gmtime_r((time_t*)&clock_secs, &tm_time);

					// Check which day of the week we are up to.
					tm_time.tm_hour = alarm.nHour%12;
					if ( alarm.nAmPm )
						tm_time.tm_hour += 12;
					tm_time.tm_min = alarm.nMin;
					tm_time.tm_sec = 0;
					uint8_t dow = tm_time.tm_wday;
					for ( uint8_t i = 0; i < 8; i++ )	// 7 + 1 days if today's alarm is already gone.
					{
						if ( alarm.dow & _BV(dow) )
						{
							// alarm set for this day.  Get seconds and see if we have passed it yet.
							time = mktime( &tm_time );
							if ( time > clock_secs )
								break;
						}
						dow++;
						if ( dow >= 6 )
							dow = 0;
						tm_time.tm_mday++;
					}
				}
				break;
		}
	}
	return time;
}

static void PrimeAlarms()
{
	terminal.Send("Priming alarms\r\n");
//bClockInitialised = true;

	nNextAlarmDue = 0;
	bool bChange = false;
	for ( uint8_t i = 0; i < countof(settings.Alarms); i++ )
	{
		if ( settings.Alarms[i].type != AlarmType::Off )
		{
			time_t timeDue = NextTimeDue( settings.Alarms[i] );
			if ( timeDue == 0 )
			{
				settings.Alarms[i].type = AlarmType::Off;
				bChange = true;
			}
			else
			{
				if ( nNextAlarmDue == 0 || timeDue < nNextAlarmDue )
					nNextAlarmDue = timeDue;
			}
		}
	}
	if ( bChange )
		WriteEEPROM();
}

static uint16_t CalcCRC16( const uint8_t *buf, uint8_t len )
{
	CRC.CTRL = CRC_RESET_RESET0_gc;
	CRC.CTRL = CRC_SOURCE_IO_gc;
	while ( len )
	{
		CRC.DATAIN = *buf;
		buf++;
		len--;
	}
	CRC.STATUS |= CRC_BUSY_bm;
	return CRC.CHECKSUM0 | (CRC.CHECKSUM1 << 8);
}

static void WriteEEPROM()
{
	uint16_t crc16 = CalcCRC16( (uint8_t *)&settings, sizeof(settings)-2 );
	settings.crc16 = crc16;
	eeprom_write_block( &settings, &eeprom_data, sizeof(settings) );

	terminal.Send("Write Intensity");
	terminal.Send(settings.nTimeIntensity);
	terminal.Send(',');
	terminal.Send(settings.nDABIntensity);
	terminal.SendCRLF();
}



static void ReadEEPROM()
{
#ifdef NOEEPROM
	memset( alarms, 0, sizeof(alarms) );

	alarms[0].type = AlarmType::OneOff;
	alarms[0].nDay = 22;
	alarms[0].nMonth = 9;
	alarms[0].nYear = 2016;
	alarms[0].nHour = 5;
	alarms[0].nMin	= 20;
	alarms[0].nAmPm	= 0;
	
	alarms[1].type = AlarmType::Scheduled;
	alarms[1].dow = 0b0111110;
	alarms[1].nHour = 5;
	alarms[1].nMin = 19;
	alarms[0].nAmPm	= 1;

	//time_t seconds1 = 1, seconds2;
	//struct tm t1, t2;
	//memset(&t1,0,sizeof(t1));
	//memset(&t2,0,sizeof(t2));
	//gmtime_r( &seconds1, &t1 );
	//seconds2 = mktime(&t1);
	//gmtime_r( &seconds2, &t2 );

	nAlarmRunTime = 60;
	nSleepTime = 60;
	nSnoozeTime = 10;
	nTimeIntensity = 0;
	nDABIntensity = 4;

	PrimeAlarms();
#else
	eeprom_read_block( &settings, &eeprom_data, sizeof(settings) );

	terminal.Send("Read Intensity");
	terminal.Send(settings.nTimeIntensity);
	terminal.Send(',');
	terminal.Send(settings.nDABIntensity);
	terminal.SendCRLF();

	uint16_t computed_crc16 = CalcCRC16( (uint8_t *)&settings, sizeof(settings)-2 );
	if ( settings.crc16 != computed_crc16 )
	{
		terminal.Send("CRC Failed"); terminal.SendCRLF();
		// CRC failed.  Init sane defaults.
		settings.nLastPlayedProgramIndex = 0;
		settings.nAlarmRunTime = 60;
		settings.nSleepTime = 60;
		settings.nSnoozeTime = 10;
		settings.Alarms[0].type = AlarmType::Off;
		settings.Alarms[0].dow = 0x7F;
		settings.Alarms[0].nAmPm = 0;
		settings.Alarms[0].nDay = 1;
		settings.Alarms[0].nMonth = 0;
		settings.Alarms[0].nYear = 2016;
		settings.Alarms[0].nHour = 7;
		settings.Alarms[0].nMin = 30;
		for ( uint8_t i = 1; i < MAX_ALARMS; i++ )
			settings.Alarms[i] = settings.Alarms[0];
		settings.crc16 = CalcCRC16( (uint8_t *)&settings, sizeof(settings)-2 );

		WriteEEPROM();
	}

	PrimeAlarms();
#endif
}

static void AlarmOn()
{
	RadioPlay();
	// Set for the next alarm.
	PrimeAlarms();
	nAlarmOffTime = clock_secs + settings.nAlarmRunTime * 60;
}

static void AlarmOff()
{
	RadioOff();
	nAlarmOffTime = 0;
	bAlarmOn = false;
}

static int8_t ProcessEncoder()
{
	const uint8_t ENCODER_RESET_TIMER = 250;			// ms
	static uint8_t nEncoderResetTimer = 0;
	static int16_t nLastEncoder = -1;
	static int8_t nEncoderDelta=0;

	int8_t nEncoderMovement = 0;

	int16_t nEncoder = TCC1.CNT;
	if ( nEncoder != nLastEncoder )
	{
		int16_t nEncoderChange = nEncoder - nLastEncoder;
		nLastEncoder = nEncoder;

		terminal.Send( "Encoder: ");
		terminal.Send( (long)nEncoder );
		terminal.SendCRLF();

		nEncoderDelta += nEncoderChange;
		nEncoderResetTimer = ENCODER_RESET_TIMER;

		while ( nEncoderDelta >= 4 )
		{
			nEncoderMovement++;
			nEncoderDelta -= 4;	// 4 encoder ticks per detent.
		}
		while ( nEncoderDelta <= -4 )
		{
			nEncoderMovement--;
			nEncoderDelta += 4;	// 4 encoder ticks per detent.
		}

		static uint8_t last_ms8 = 0;
		uint8_t ms8 = *(uint8_t *)&ms;
		if ( ms8 != last_ms8 )
		{
			last_ms8 = ms8;

			// Clear the encoder count of funny results, not resting on even multiple of 4.
			if ( nEncoderResetTimer )
			{
				nEncoderResetTimer--;
				if ( nEncoderResetTimer == 0 )
					nEncoderDelta =0;
			}
		}
	}
	return nEncoderMovement;
}

int main(void)
{
	ioinit();

	// debug 115200
	int BSEL = 524;
	int BSCALE = -5;
	terminal.Init( MAKE_XBAUD( BSCALE, BSEL )  );

	// DBA chip is 57600
	BSEL = 540;
	BSCALE = -4;
	dab.Init( MAKE_XBAUD( BSCALE, BSEL )  );

	sei();

	ReadEEPROM();
	bAlarmOn = false;

	terminal.Send( "\r\nDBA Clock Radio Starting\r\n");
	sevenSeg_I2C.Start();
	sevenSeg_I2C.SetBrightness(settings.nTimeIntensity);

	terminal.Send( "Resetting radio - ");
	dab.AsyncStart();
	display.setBrightness(settings.nDABIntensity);

	programs = (Programs *)__malloc_heap_start;
	nLastVolume = 0;

	nNextProgram = settings.nLastPlayedProgramIndex = 0;
	uint16_t last_tick = 0;
	uint16_t delta_tick = 0;
	bool bFlash = true;
	ShowTime(clock_secs);
    while (1) 
    {
		if ( ( RTC.STATUS & RTC_SYNCBUSY_bm ) == 0 )
		{
			uint16_t rtc = RTC.CNT;
			if ( rtc != last_tick )
			{
				bool bChange = false;
				delta_tick += rtc - last_tick;
				last_tick = rtc;
				while ( delta_tick >= 4 )
				{
					clock_secs++;
					delta_tick -= 4;
					bChange = true;
				}
				if ( bChange )
				{
					if ( !bClockInitialised )
					{
						ShowTime(clock_secs);
					}
					else
					{
						if ( clock_secs % 60 == 0 )
							ShowTime(clock_secs);
						else
							FlashColon(true);
					}
					bFlash = true;
					terminal.Send("tick\r\n");
					if ( nNextAlarmDue && !bAlarmOn )
					{
						if ( clock_secs > nNextAlarmDue )
						{
							bAlarmOn = true;
							// Start alarm
							AlarmOn();
						}
					}
					if ( nAlarmOffTime && nAlarmOffTime < clock_secs )
					{
						AlarmOff();
					}
				}
			}
			else if ( bFlash && (rtc & 2) != 0 )
			{
				if ( !bClockInitialised )
					ClearDisplay();
				else
					FlashColon(false);
				bFlash = false;
			}
		}

		int8_t nEncoder = ProcessEncoder();

		uint16_t key_changes=0;
		static uint8_t last_ms = -1;
		uint8_t ms8 = *(uint8_t *)&ms;
		if ( last_ms != ms8 )
		{
			key_changes = PollKeyboard();
			if ( key_changes )
			{
				terminal.SendHex((int)key_changes);
				terminal.SendCRLF();
			}
			last_ms = ms8;

			if ( ( !bClockInitialised ||
				   displayMode == DisplayMode::Scanning )
				 && (ms8 % 20) == 0 )
			{
				Spinner();
			}
		}



		static uint8_t last_adc = 0;
		if ( last_adc != ms8 )
		{
			last_adc = ms8;
			static uint8_t n = 0;
			static uint16_t sum = 0;

			if ( ADCA.CH0.INTFLAGS & ADC_CH_CHIF_bm )
			{
				ADCA.CH0.INTFLAGS |= ADC_CH_CHIF_bm;
				sum += ADCA.CH0.RES;
				n++;
				if ( n == 64 )
				{
					volumeSetting = ConvertVolume(sum >> 6);
					n = 0;
					sum = 0;
				}
				ADCA.CH0.CTRL |= ADC_CH_START_bm;
			}
		}

		DoClockRadio(key_changes, nEncoder);
		DoDAB();

		//static int16_t t=0;
		//display.WriteText(&font_6x13, 258+t,0,"test1");
		//display.WriteText(&font_6x13, 259+t,11,"test2");
		//display.WriteText(&font_6x13, 260+t,23,"test3");
		//display.WriteText(&font_6x13, 261+t,35,"test4");
//
		//display.WriteText(&font_6x13,  0-t,0,"test1");
		//display.WriteText(&font_6x13, -1-t,11,"test2");
		//display.WriteText(&font_6x13, -2-t,23,"test3");
		//display.WriteText(&font_6x13, -3-t,35,"test4");
		//t++;
    }
}



/*

DAB

- Radio On
	EnableSyncClock
	Play
	Volume
- Radio Off
	PowerOff

- Clock
	- Idle
	- Radio Play
	- Sleep
	- Alarm
	- Menu



-- TODO 
	- display  other info.

	- fm support?
		- beeper?

	- ldr for autobrightness.

	-- Menu - when off, encoder scrolls menu.  Use alarm1/2 buttons?
		-- alarm(s)
			- one off
				- date, time.
			- mon/tue/wed/thr/fri/sat/sun
				- time
			enabled
			alarm type: oneoff, scheduled;
			one off: oneoff time, oneoff date.
			scheduled: DOW bitmask, time
		-- alarm run time.
		-- rescan DAB
			-- factory reset?
		-- different display layouts
		-- other?
		-- sleep time, snooze time.

	-- if program count = 0 dab scan (or just menu?)

	-- show date, when tick over to the next day. (if we are playing).


*/
