ftkalcevic/DABClockRadio/(commit log)

2016-09-29 Add keypad and encoder.
2016-10-09 Refactor task lists
    [SpinnerCalcs.xlsx]
2016-10-22 EEPROM. Minor bug fixes
    [main.cpp]
2016-10-28 Bug fixes to get it working properly
    [VolumeCalcs.xlsx]
2020-02-14 Put eeprom into struct to make crc calc easier
    Fix start up clock set bug, attempting to select program when there are none.
    [main.cpp, monkeyboarddab.h]
2020-02-15 Fix channel scan timeout bug
    [main.cpp]
